DQQ141/PA01/PA01/tools/git_release/release.md

## v1.0.2_release
**Commit:** 04bceb5ce21f668a233e332e9795bd27d4be1026  
**Tagger:** wittxie <wittxie@qq.com>  
**Date:** 2024-12-19 16:16:50 +0800  
**Instructions:**  
  - 外部接口测试页面下打开外部RF电源

---

## v1.0.2_b4
**Commit:** ee4cefda445eccbde6d5258459ebe2d6e53804b8  
**Tagger:** wittxie <wittxie@qq.com>  
**Date:** 2024-12-16 14:38:42 +0800  
**Instructions:**  
  - 默认功率从20dBm改为16dBm

---

## v1.0.2_b3
**Commit:** ab9347e065dc001b2841cdf46fb90238714880c8  
**Tagger:** wittxie <wittxie@qq.com>  
**Date:** 2024-12-16 12:48:05 +0800  
**Instructions:**  
  - 1. 修复protocol丢帧的BUG
  - 2. ring增加传参0判断
  - 3. print_hex8单空格间距

---

## v1.0.2_b2
**Commit:** d0d055a839de3cfe7aa338e8ff0e1452057d1e54  
**Tagger:** wittxie <wittxie@qq.com>  
**Date:** 2024-12-13 13:18:13 +0800  
**Instructions:**  
  - 1. 完成正常模式下的功率设置
  - 2. 串口初始化前先等待RF模块发生的异常波形过去后再初始化

---

## v1.0.2_b1
**Commit:** 098d7aa7b52782c238bbde7deaab07fcfc0df1e0  
**Tagger:** wittxie <wittxie@qq.com>  
**Date:** 2024-12-12 15:29:28 +0800  
**Instructions:**  
  - 新增续航测试页

---

## v1.0.1_b3
**Commit:** fc07d292a5cbe6a9ef467b65b83d4468ac0f9444  
**Tagger:** wittxie <wittxie@qq.com>  
**Date:** 2024-12-10 14:19:28 +0800  
**Instructions:**  
  - 每次发送数据前清空不用的数据

---

## v1.0.1_release
**Commit:** fc07d292a5cbe6a9ef467b65b83d4468ac0f9444  
**Tagger:** wittxie <wittxie@qq.com>  
**Date:** 2024-12-10 14:19:28 +0800  
**Instructions:**  
  - 每次发送数据前清空不用的数据

---

## v1.0.1_b2
**Commit:** 3b72fed73c4d23d7900a8acbd945a6e80e5c2381  
**Tagger:** wittxie <wittxie@qq.com>  
**Date:** 2024-12-10 12:32:48 +0800  
**Instructions:**  
  - 支持V0和V1接收机切换

---

## v1.0.1_b1
**Commit:** 788acda2a361638792b804124892cb0fa8a881c6  
**Tagger:** wittxie <wittxie@qq.com>  
**Date:** 2024-12-10 12:07:15 +0800  
**Instructions:**  
  - 高频认证模式完成

---

## v1.0.0_b6
**Commit:** 77cc065142b8deddcf247d58df7aa7a4046894f5  
**Tagger:** wittxie <wittxie@qq.com>  
**Date:** 2024-12-09 17:23:05 +0800  
**Instructions:**  
  - 1. 修复TypeC测试死机问题
  - 2. 新增功能：RF未响应数据重发
  - 3. 添加看门狗

---

## v1.0.0_b5
**Commit:** 3fc2670b478b5531a9b182b62b596d631e8f7c38  
**Tagger:** wittxie <wittxie@qq.com>  
**Date:** 2024-12-07 23:40:01 +0800  
**Instructions:**  
  - 修复按键测试退出问题

---

## v1.0.0_b4
**Commit:** 644185dd22e365a05aa147c94f5cad350c7add18  
**Tagger:** wittxie <wittxie@qq.com>  
**Date:** 2024-12-07 23:12:10 +0800  
**Instructions:**  
  - 高频和对码V1接收机完成

---

## v1.0.0_b3
**Commit:** 9eb55bb4695a44aec0bb8dbfb28f3d579363e52e  
**Tagger:** wittxie <wittxie@qq.com>  
**Date:** 2024-12-05 22:20:41 +0800  
**Instructions:**  
  - 修复RF固件烧录BUG

---

## v1.0.0_b2
**Commit:** d2f1b89308b18addcdb1949ca973b33defe94057  
**Tagger:** wittxie <wittxie@qq.com>  
**Date:** 2024-12-05 19:05:11 +0800  
**Instructions:**  
  - 完成RF配对功能

---

## v1.0.0_b1
**Commit:** f53dcdbf9bfdfa1f80bacb7604cda74ef678a0b2  
**Tagger:** wittxie <wittxie@qq.com>  
**Date:** 2024-12-05 15:50:36 +0800  
**Instructions:**  
  - 喇叭使能IO口变更PE4

---

## v0.1.3_release
**Commit:** aa7b25e2473075bff66c4d8f1b2460140ef6d70b  
**Tagger:** wittxie <wittxie@qq.com>  
**Date:** 2024-12-03 22:29:36 +0800  
**Instructions:**  
  - 修复BUG:摇杆概率位置显示在左上角
  - 修改FS_PROTOCOL_INRM303一些宏定义

---

## v0.1.3_b12
**Commit:** 76fbbc01c9f5d539a68e3269c339a0af2bb53e45  
**Tagger:** wittxie <wittxie@qq.com>  
**Date:** 2024-12-03 22:11:37 +0800  
**Instructions:**  
  - 修复BUG: 串口测试sport口测试失败

---

## v0.1.3_b11
**Commit:** 076f6f44207169b7c5fce6a1fd8f72ffb8075917  
**Tagger:** wittxie <wittxie@qq.com>  
**Date:** 2024-11-30 17:08:45 +0800  
**Instructions:**  
  - 完成: RF烧录功能完成
  - 
  - 其他: 修改log开关宏

---

## v0.1.3_b10
**Commit:** e71e97c3d4904d2e208e63744a1c109c7291d933  
**Tagger:** wittxie <wittxie@qq.com>  
**Date:** 2024-11-29 20:05:08 +0800  
**Instructions:**  
  - 修复sport通信问题

---

## v0.1.3_b9
**Commit:** 3da8f8a98664e5843cbe4c928462b59ffc0ebcc0  
**Tagger:** wittxie <wittxie@qq.com>  
**Date:** 2024-11-28 22:54:37 +0800  
**Instructions:**  
  - 测试板联调完成

---

## switch_lib_v1.0.1
**Commit:** 6b045651e23eb886eb2212f4c999220ce58efb17  
**Tagger:** wittxie <wittxie@qq.com>  
**Date:** 2024-11-28 16:37:36 +0800  
**Instructions:**  
  - 独立lib

---

## v0.1.3_b8
**Commit:** e4774dde0d212d7c69d922db7c4798f6c709d17b  
**Tagger:** wittxie <wittxie@qq.com>  
**Date:** 2024-11-28 11:56:22 +0800  
**Instructions:**  
  - 拓展IO输出模式默认为推挽

---

## v0.1.3_b7
**Commit:** c5c5642318281350723eaa3e78583f9bd92a3801  
**Tagger:** wittxie <wittxie@qq.com>  
**Date:** 2024-11-27 19:18:02 +0800  
**Instructions:**  
  - 屏幕无残影

---

## v0.1.3_b6
**Commit:** 73004644104cb0097333e159d59023580881802e  
**Tagger:** wittxie <wittxie@qq.com>  
**Date:** 2024-11-25 12:32:03 +0800  
**Instructions:**  
  - 更换FLASH芯片为: MX25L25645G内存芯片

---

## v0.1.3_b5
**Commit:** 3d89d350d95c874a6f5c475836dc4f9e2debd06a  
**Tagger:** wittxie <wittxie@qq.com>  
**Date:** 2024-11-22 22:02:30 +0800  
**Instructions:**  
  - 完成充电检测：USB，底座

---

## v0.1.3_b4
**Commit:** 8ff39e654846d433be48015c45a966b6c40d5734  
**Tagger:** wittxie <wittxie@qq.com>  
**Date:** 2024-11-22 20:13:25 +0800  
**Instructions:**  
  - 优化播放逻辑

---

## v0.1.3_b3
**Commit:** f22743bf04908b84b08a5384ffd739688432eef8  
**Tagger:** wittxie <wittxie@qq.com>  
**Date:** 2024-11-22 18:21:30 +0800  
**Instructions:**  
  - 优化警告等细节

---

## v0.1.3_b2
**Commit:** 2c469fa6db0fae60f30ec917674fa6badc93d531  
**Tagger:** wittxie <wittxie@qq.com>  
**Date:** 2024-11-22 13:09:03 +0800  
**Instructions:**  
  - 1. heap4改为heap5，加大OS内存
  - 2. 关机前先让屏幕进入睡眠模式

---

## v0.1.3_b1
**Commit:** 932497447639998d7fc42c032581a5f15675df51  
**Tagger:** wittxie <wittxie@qq.com>  
**Date:** 2024-11-21 23:09:22 +0800  
**Instructions:**  
  - 1.定时刷新屏幕寄存器
  - 2.重写player，改为声音专用播放器

---

## v0.1.2
**Commit:** 8230a77e9f39f45e246ddd8b9e747bbc89dcf313  
**Tagger:** wittxie <wittxie@qq.com>  
**Date:** 2024-11-20 23:07:33 +0800  
**Instructions:**  
  - 声音完成

---
