DQQ141/PA01/PA01/tools/replace/搜索技巧.md

所有括号内的内容：`\((.*?)\)`

所有括号外部的内容：`^[^(]+|[^)]+$`
