DQQ141/PA01/PA01/doc/原理图/主板原理图 v0.0.2.pdf

BAT Voltage Detection | DC BUCK +3V3

3A

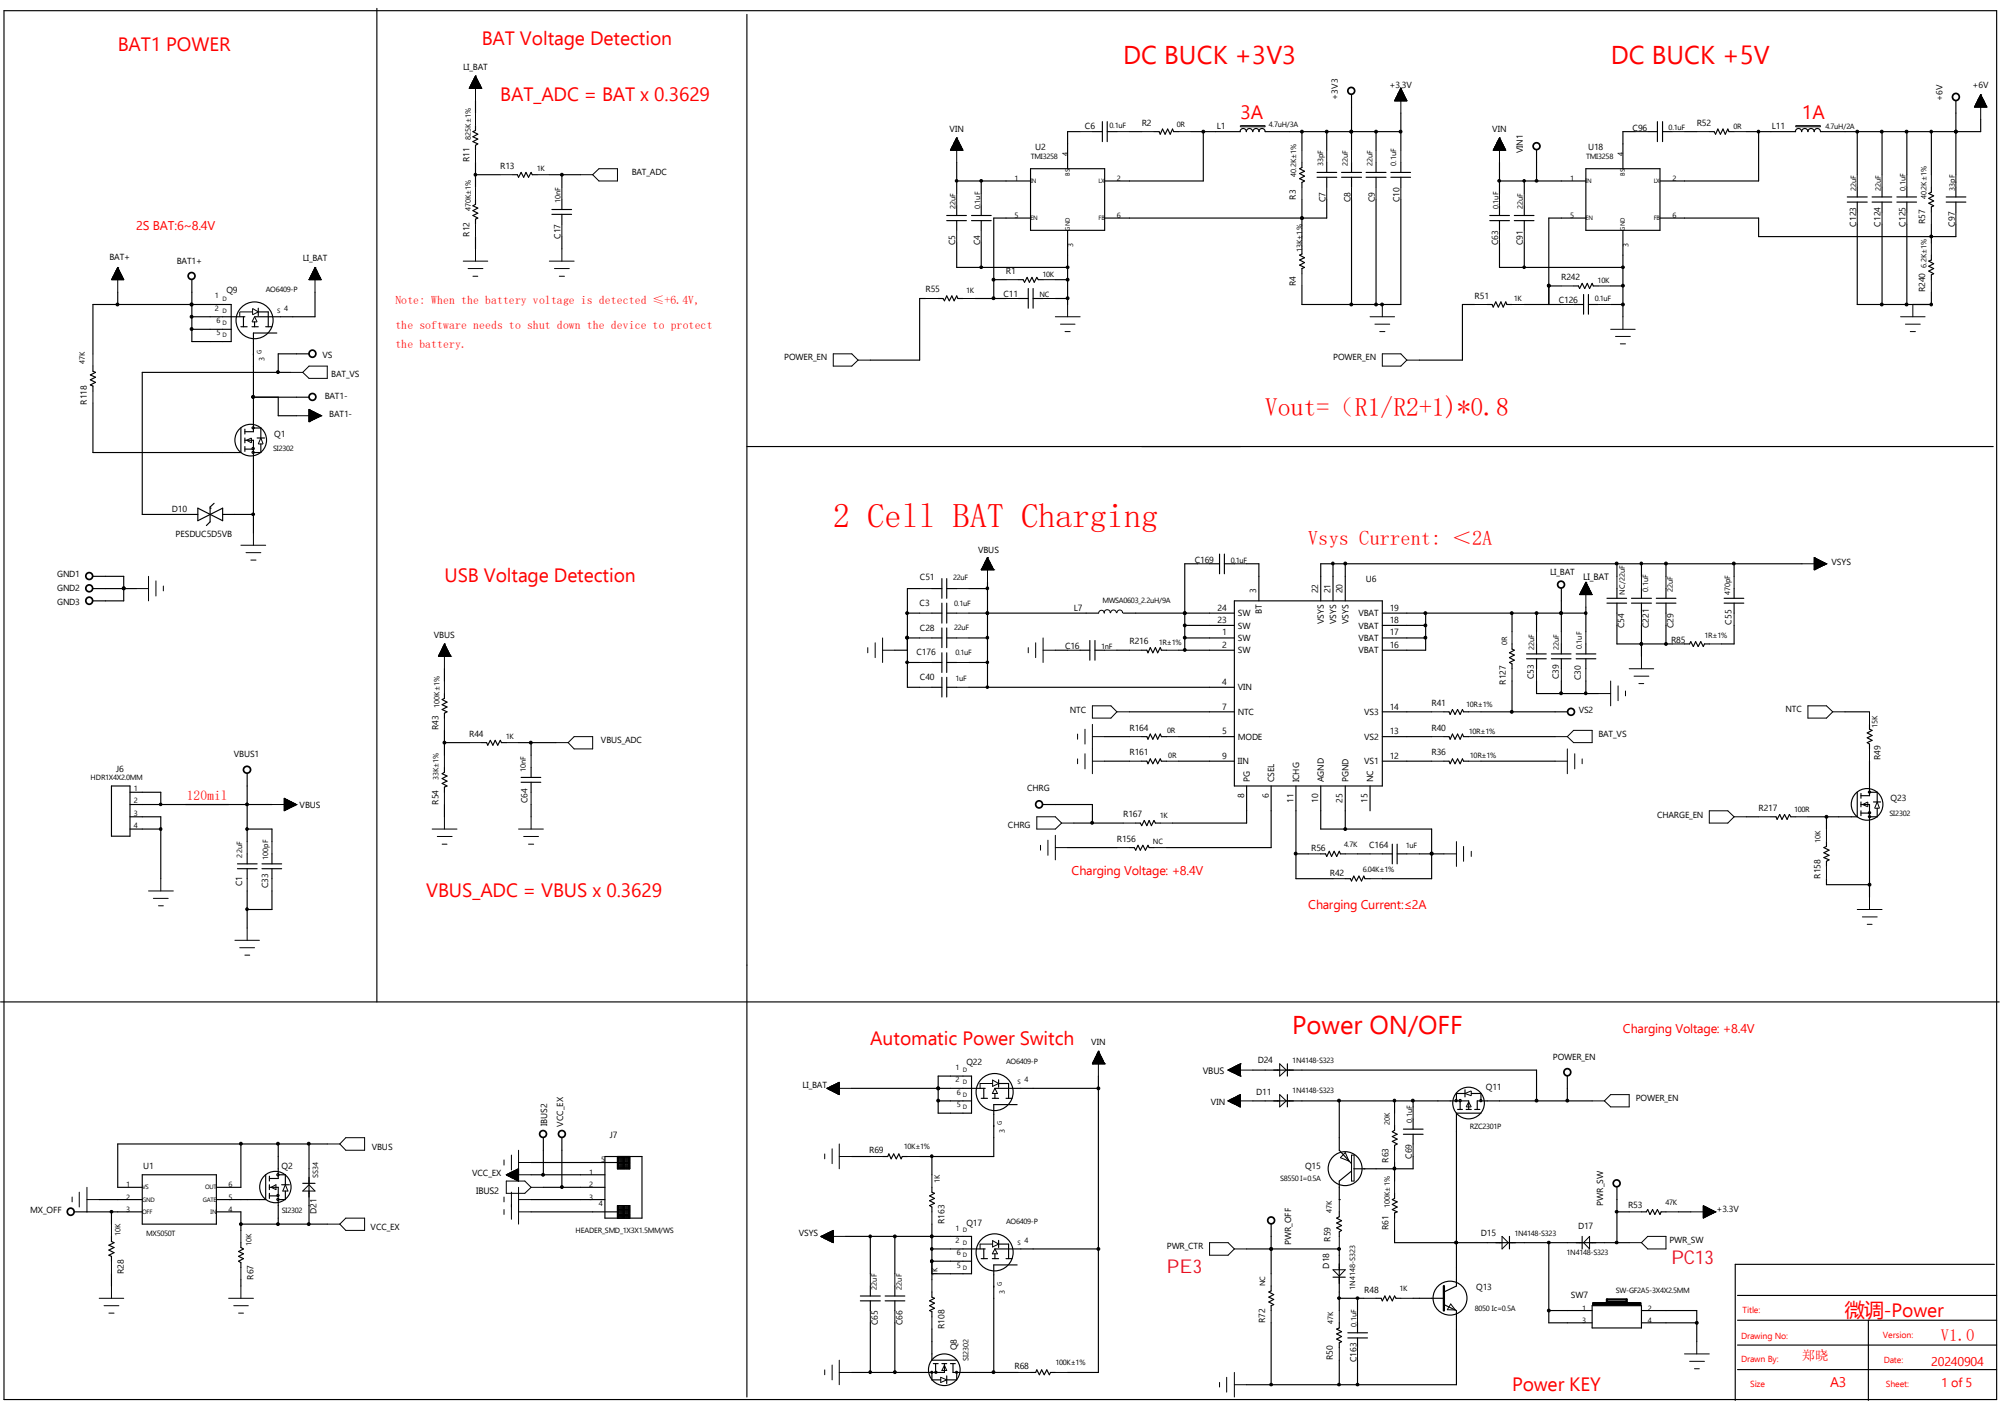
[picture p9: page 1]

Note: When the battery voltage is detected ≤+6.4V,

the software needs to shut down the device to protect
the battery.

Drawing No: | V1.0 Version:
郑晓 Drawn By: | Date:

A3 Size | Sheet:

TR3- | TR3+ | TR4+ | TR4-
| | TR2- | TR2+

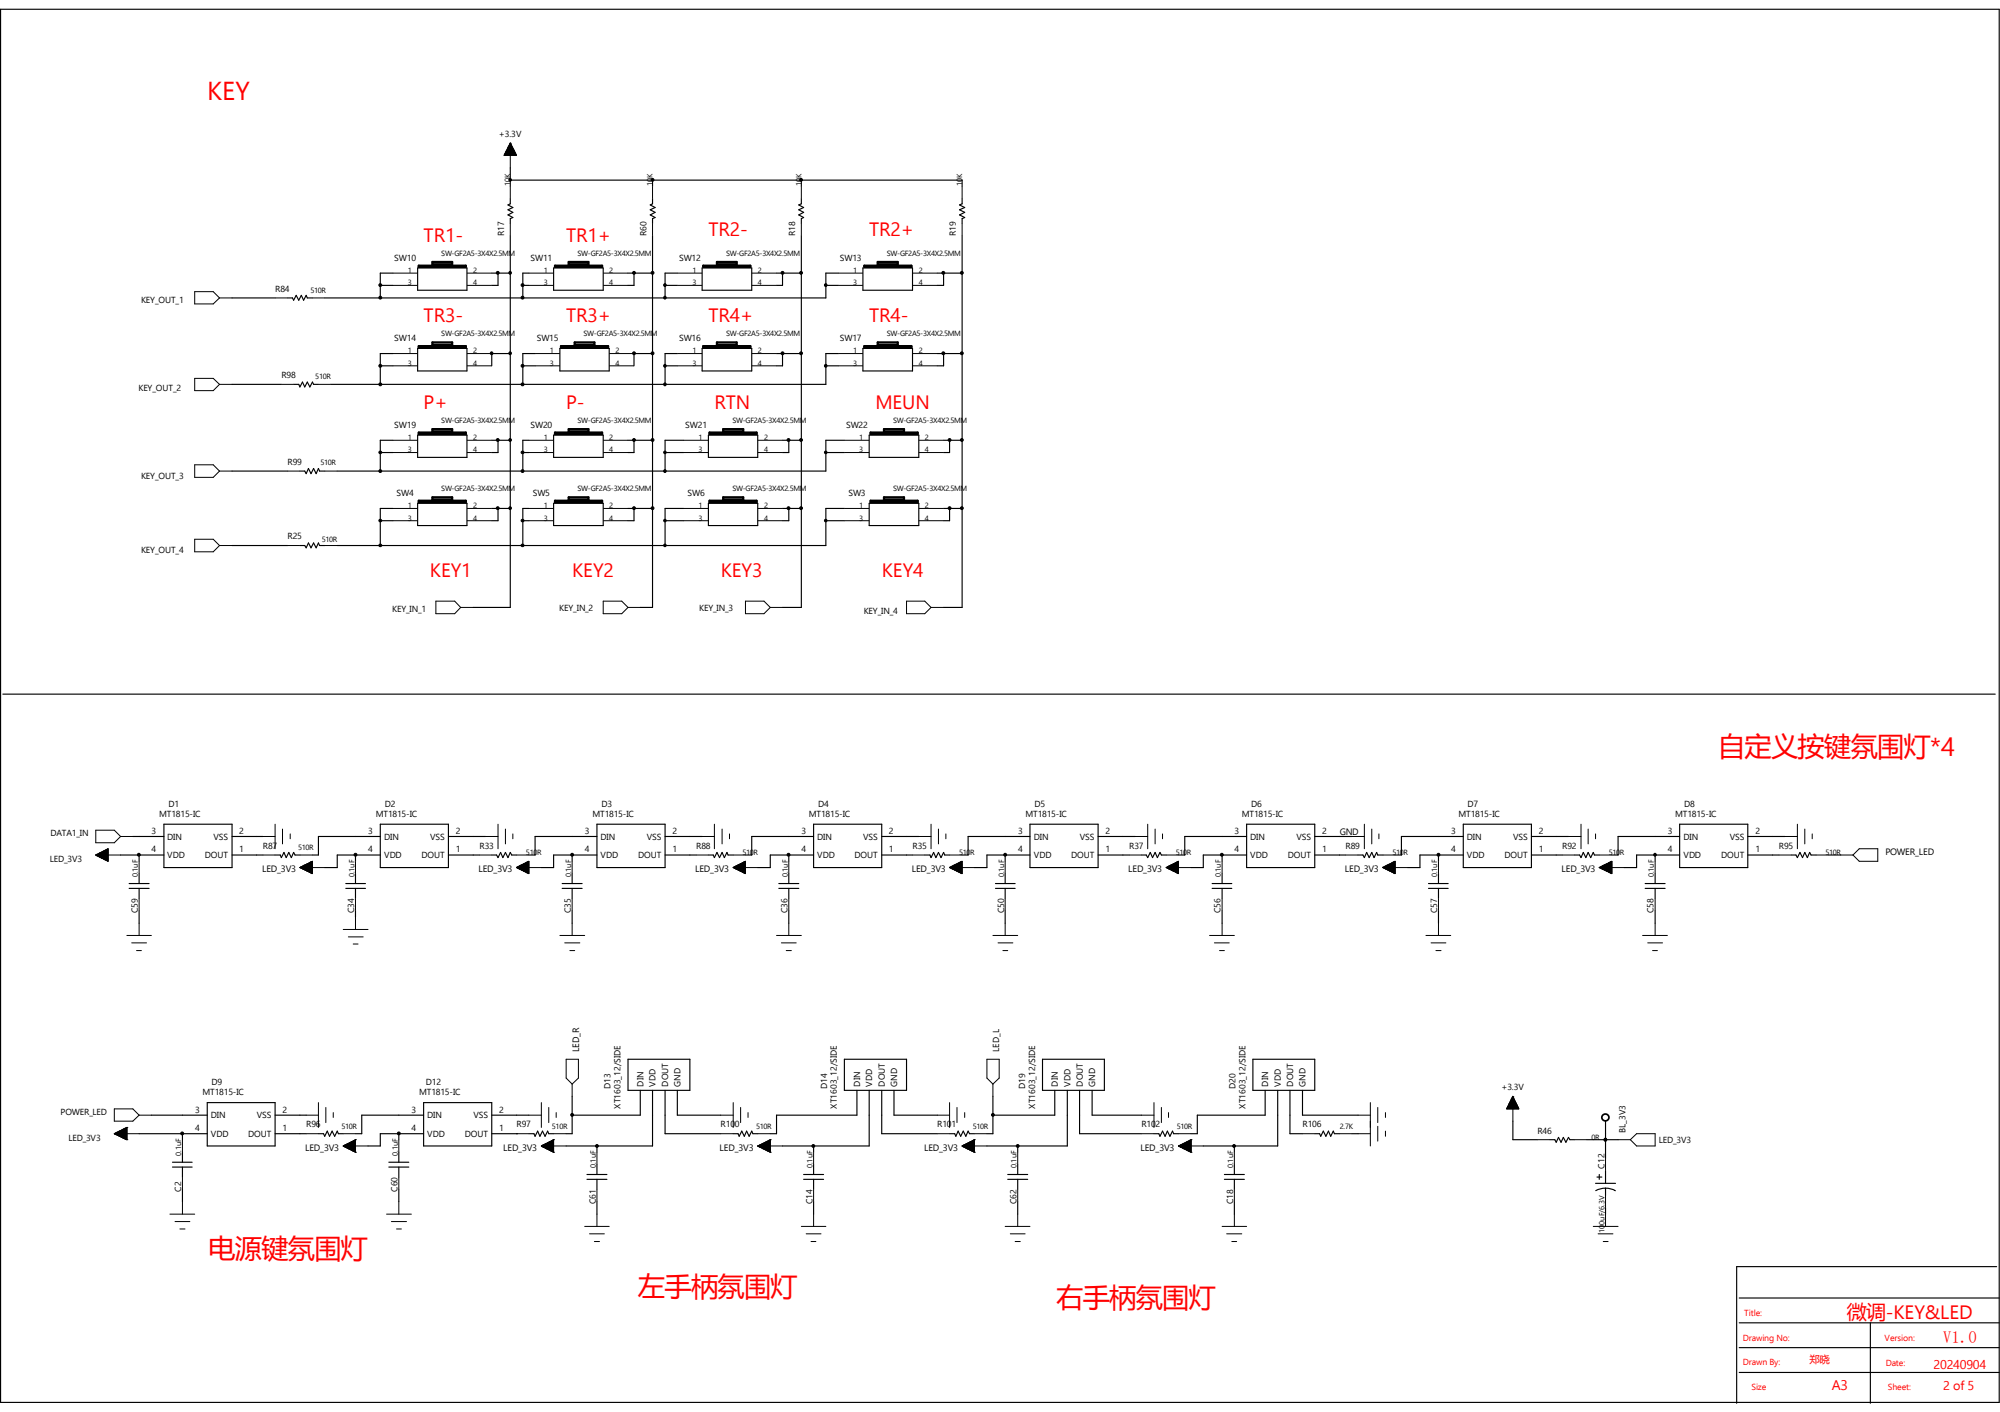
[picture p10: page 2]

# VR2 VR1

# Potentiometer Knob

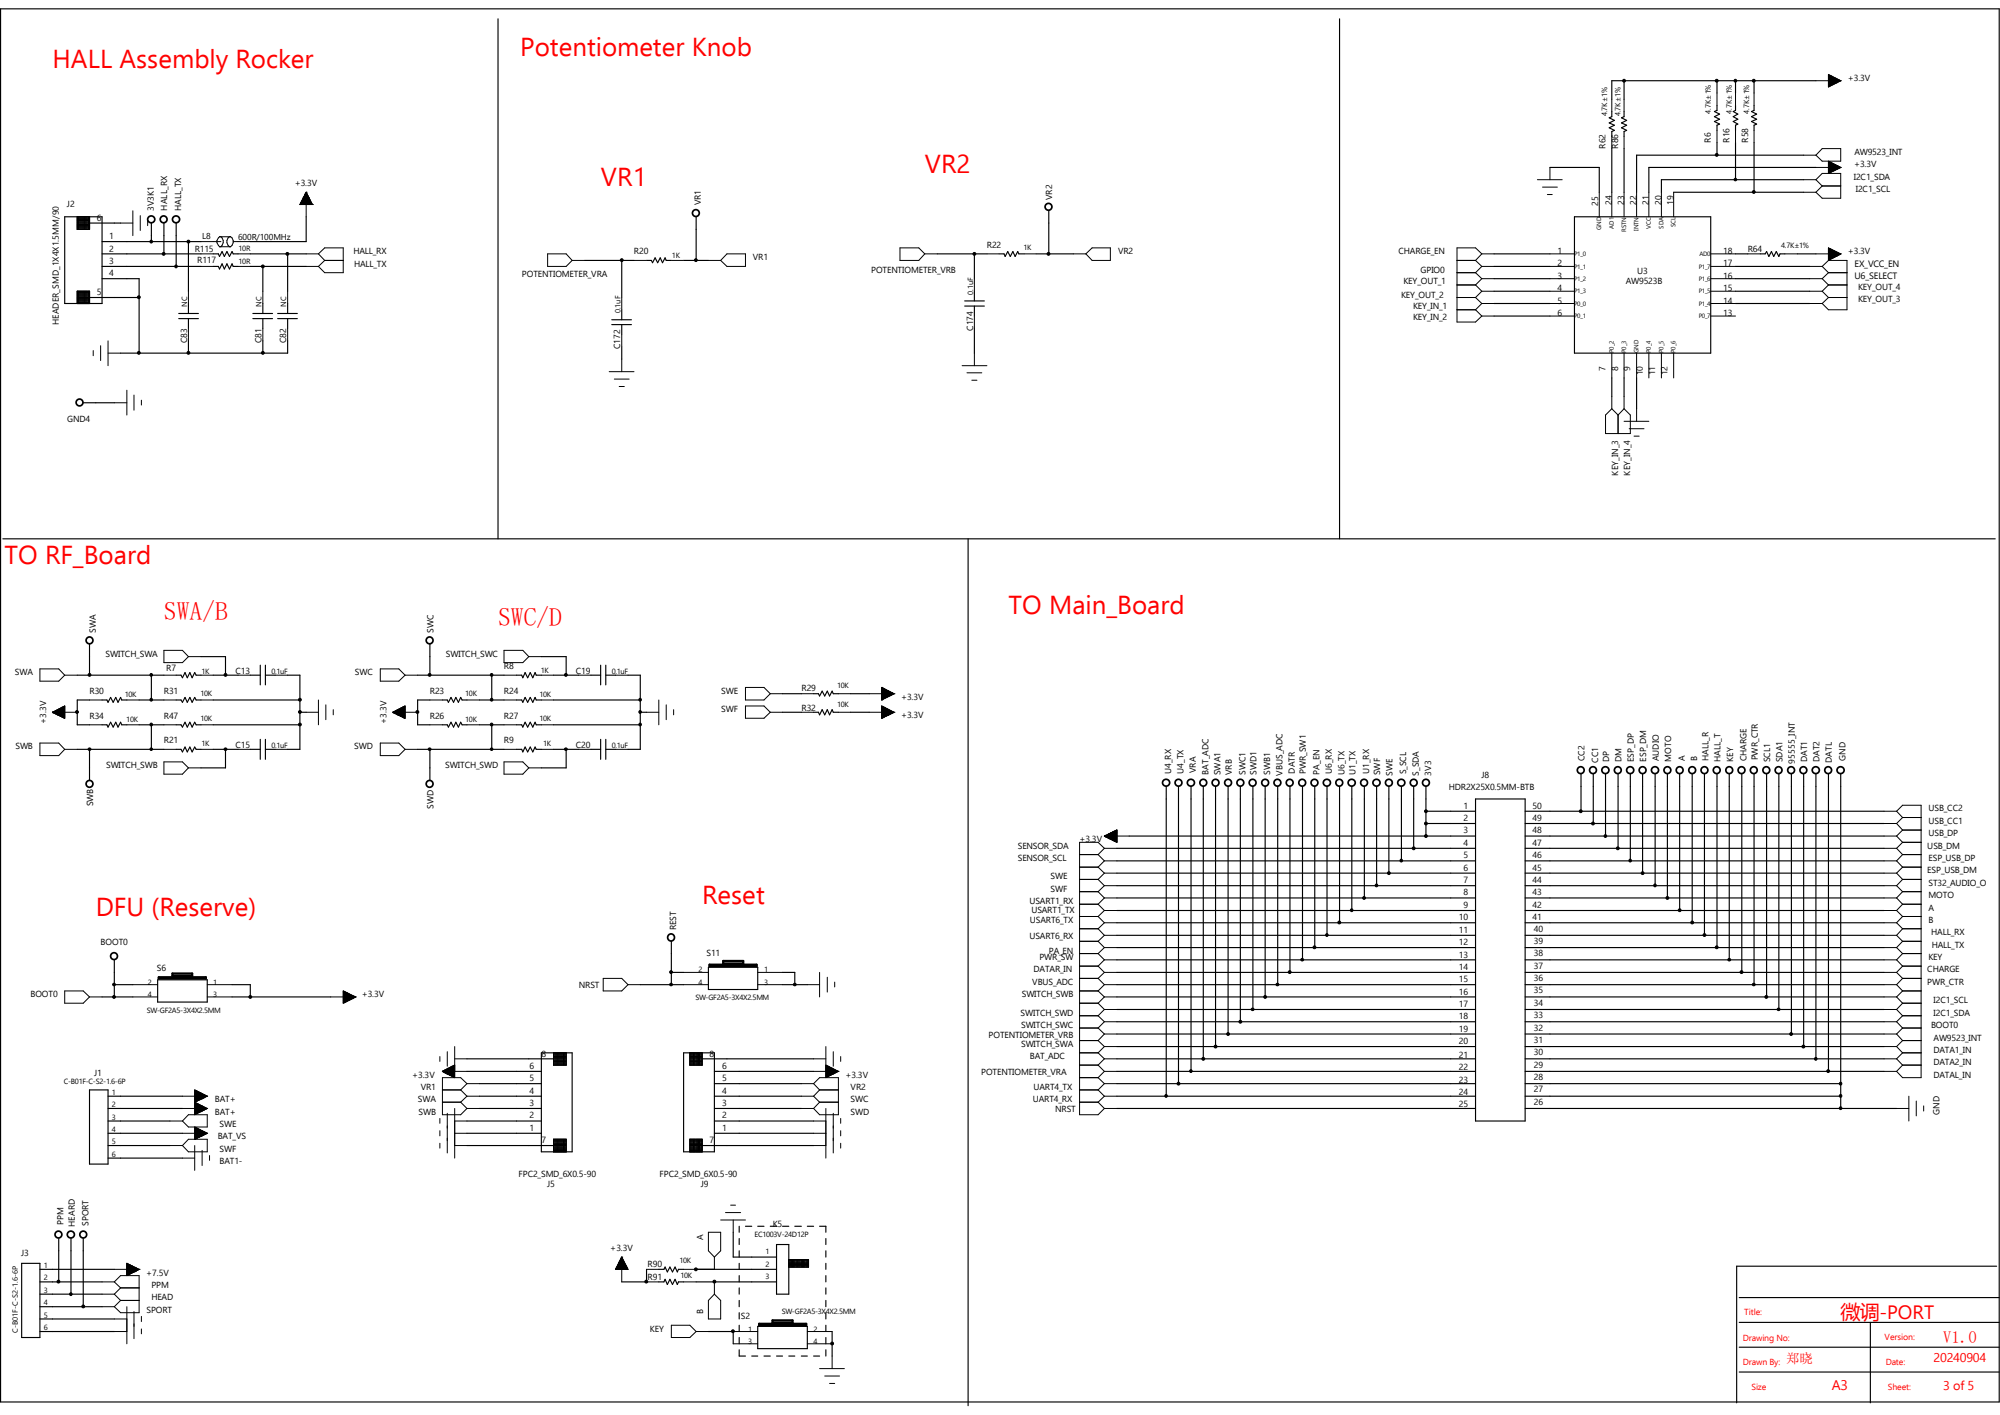
[picture p11: page 3]

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
# Audio Outputs

# Gyroscope

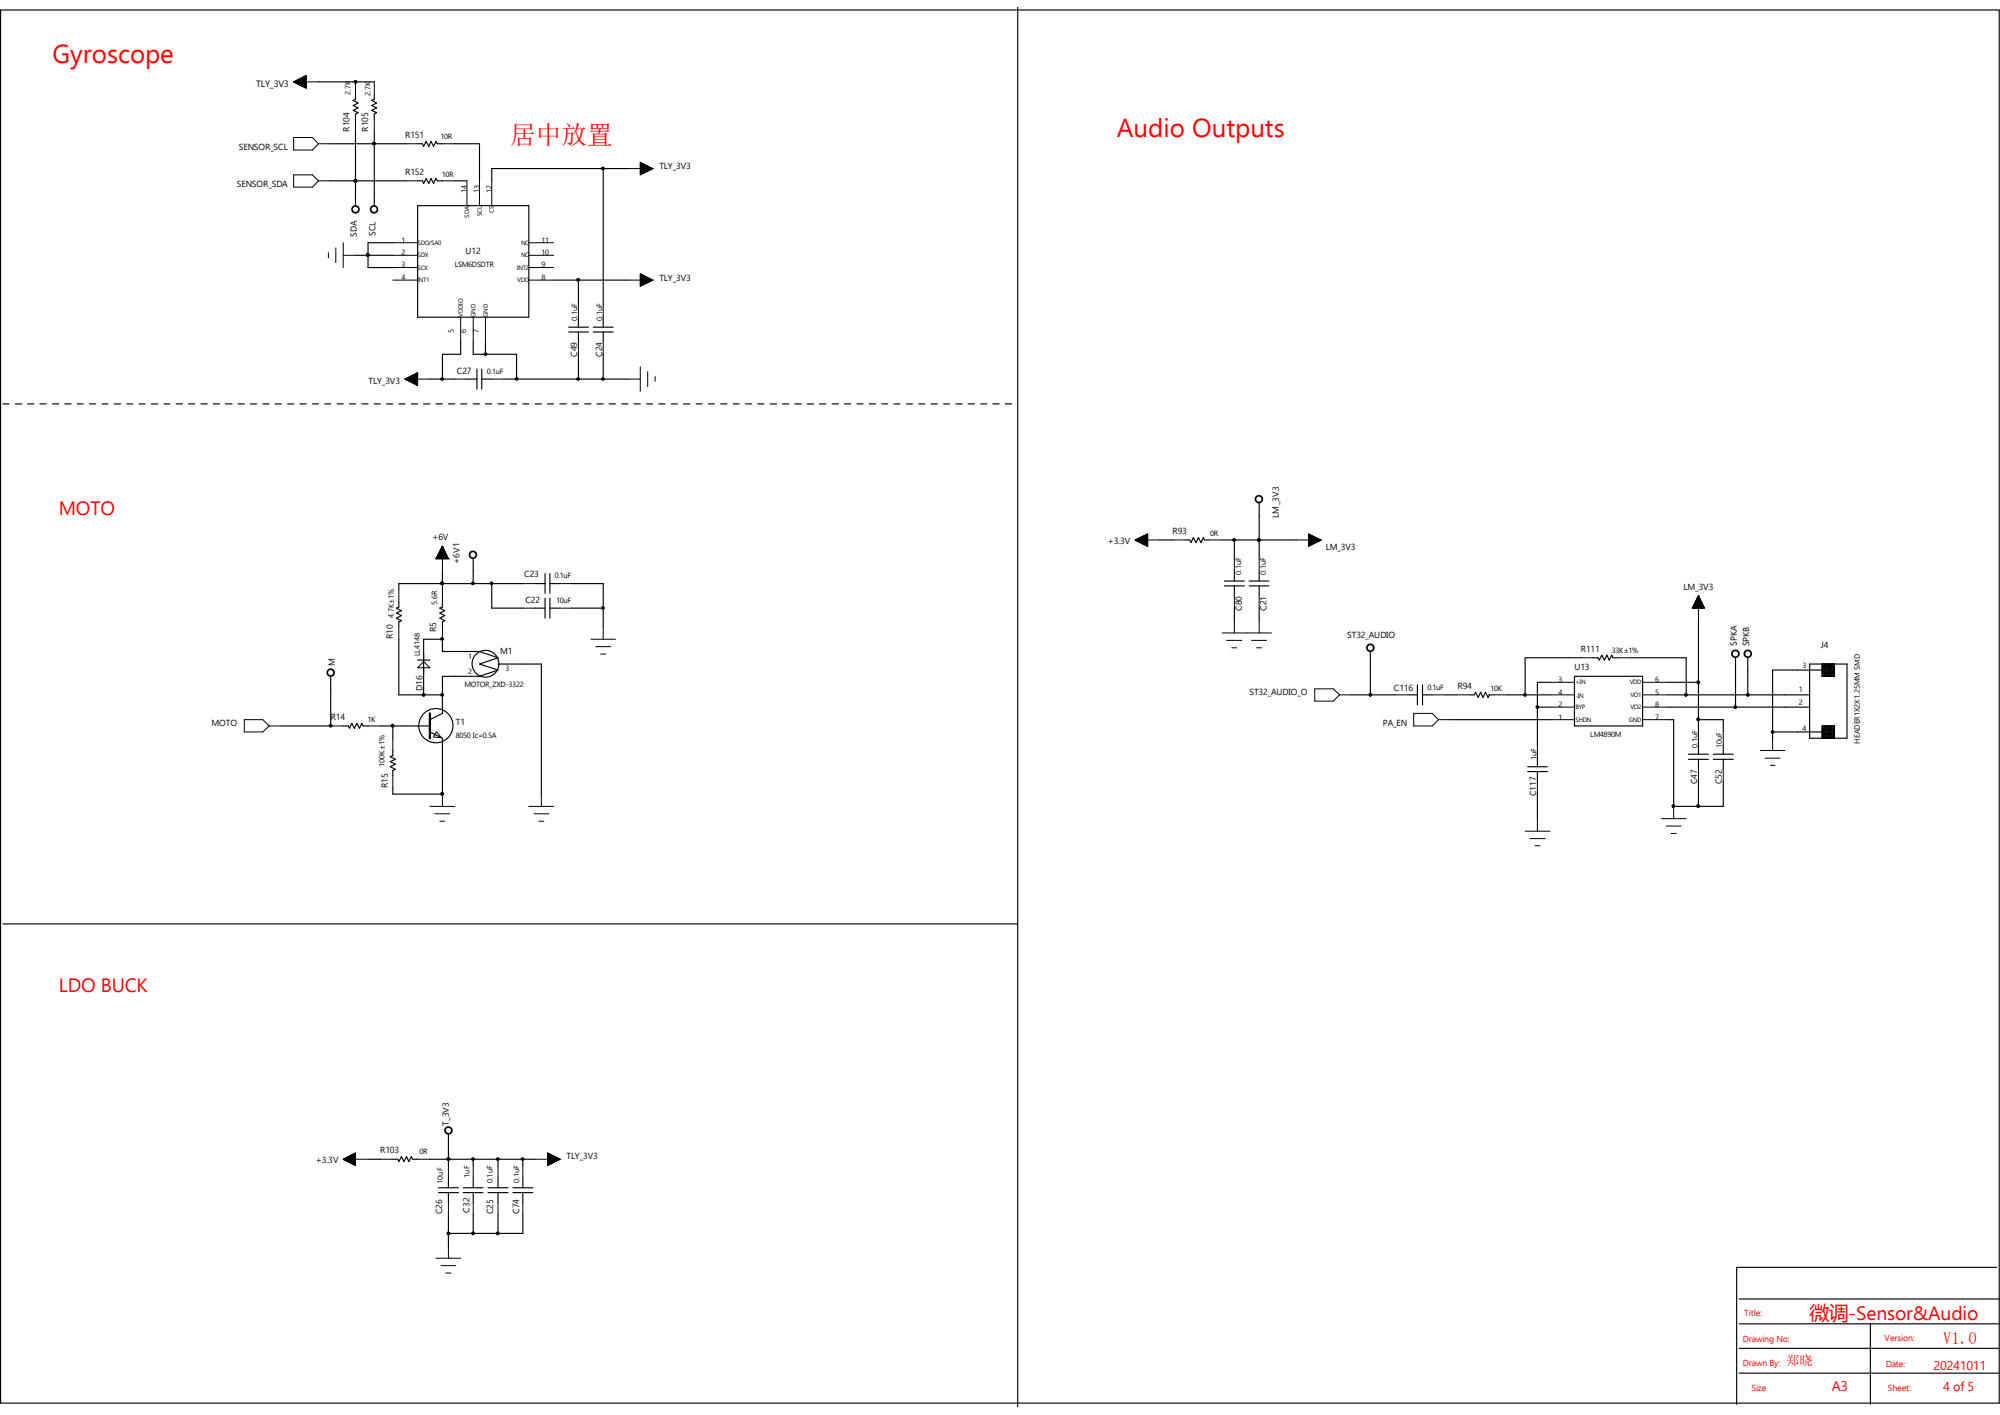
[picture p12: page 4]

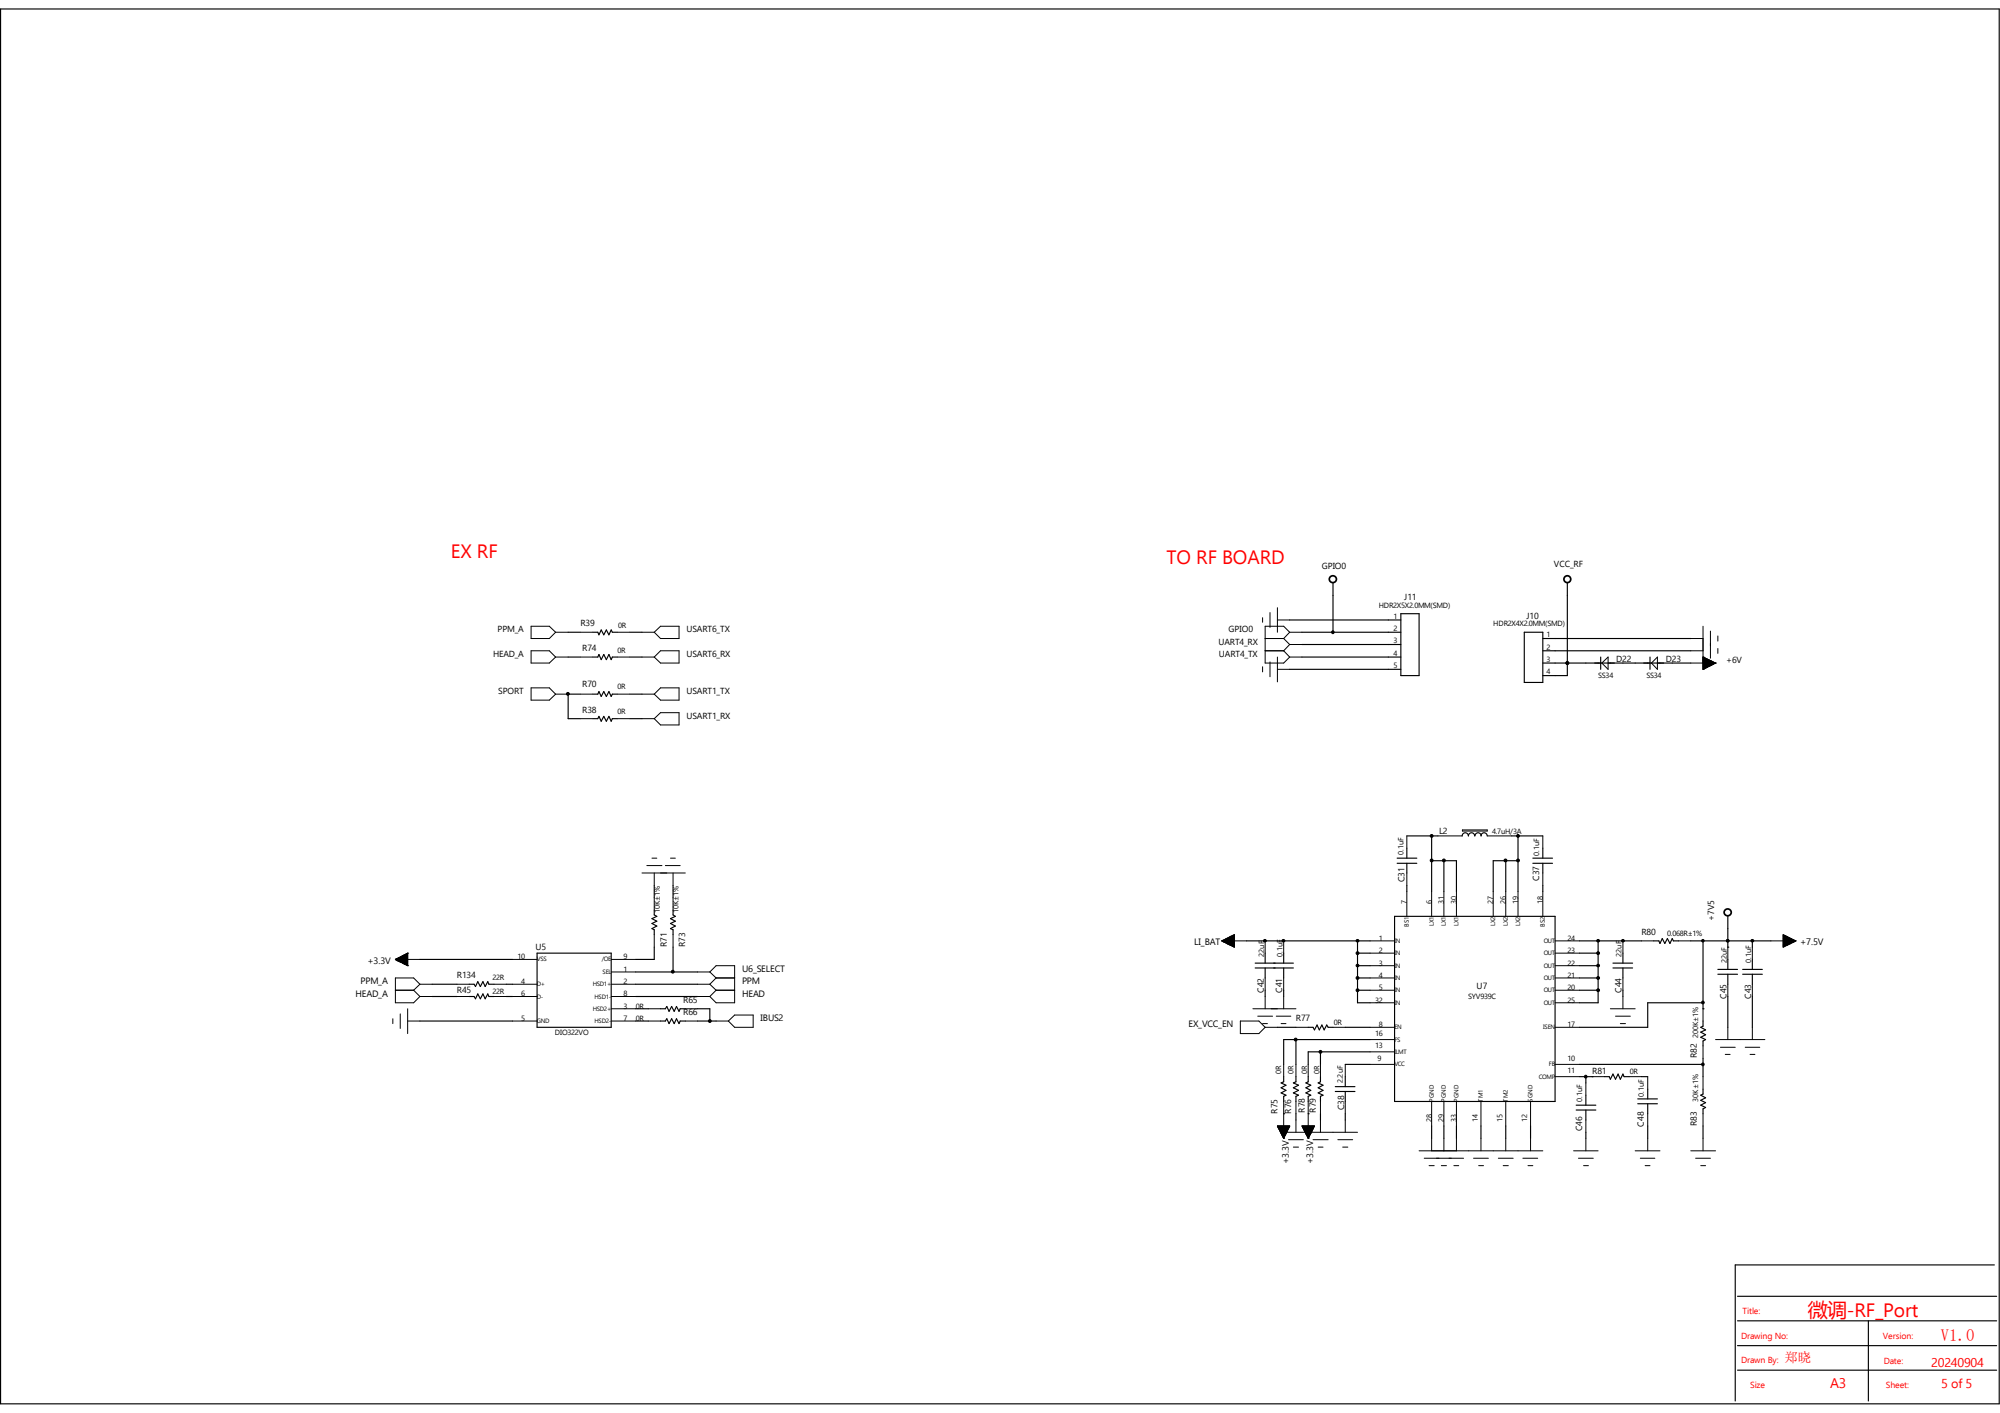
[picture p13: page 5]
