DQQ141/PA01/PA01/doc/原理图/核心板原理图 v0.0.2.pdf

## 120mil

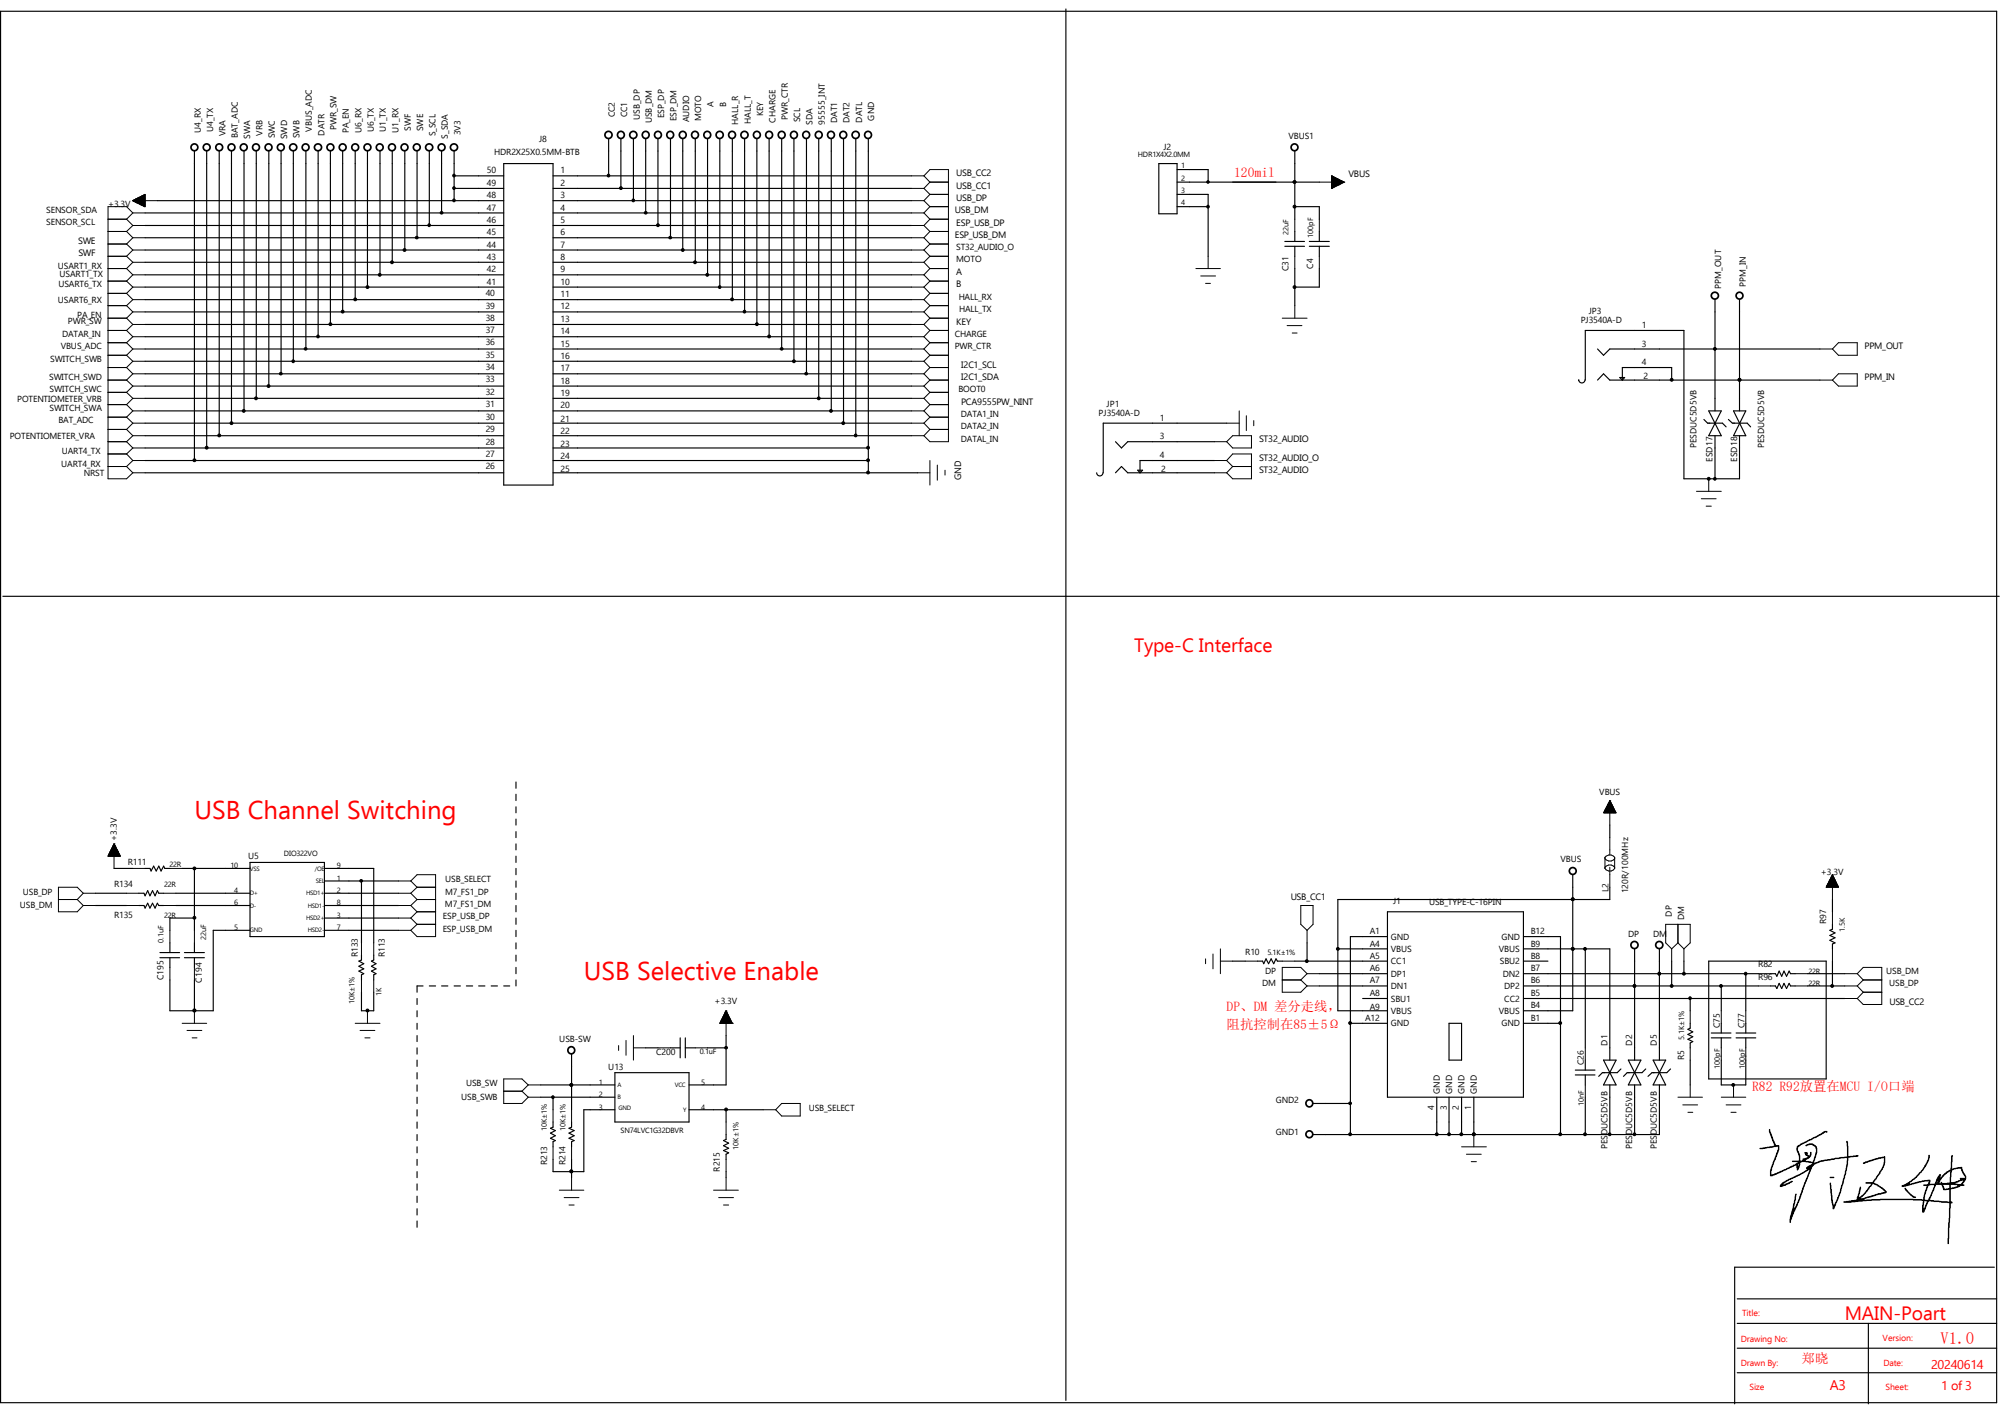
[picture p14: page 1]

VBUS1

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
Drawing No: | Version: V1.0
郑晓 Drawn By: | Date:

Size A3 | Sheet:

# Reset

# SDRAM 64M 16bit

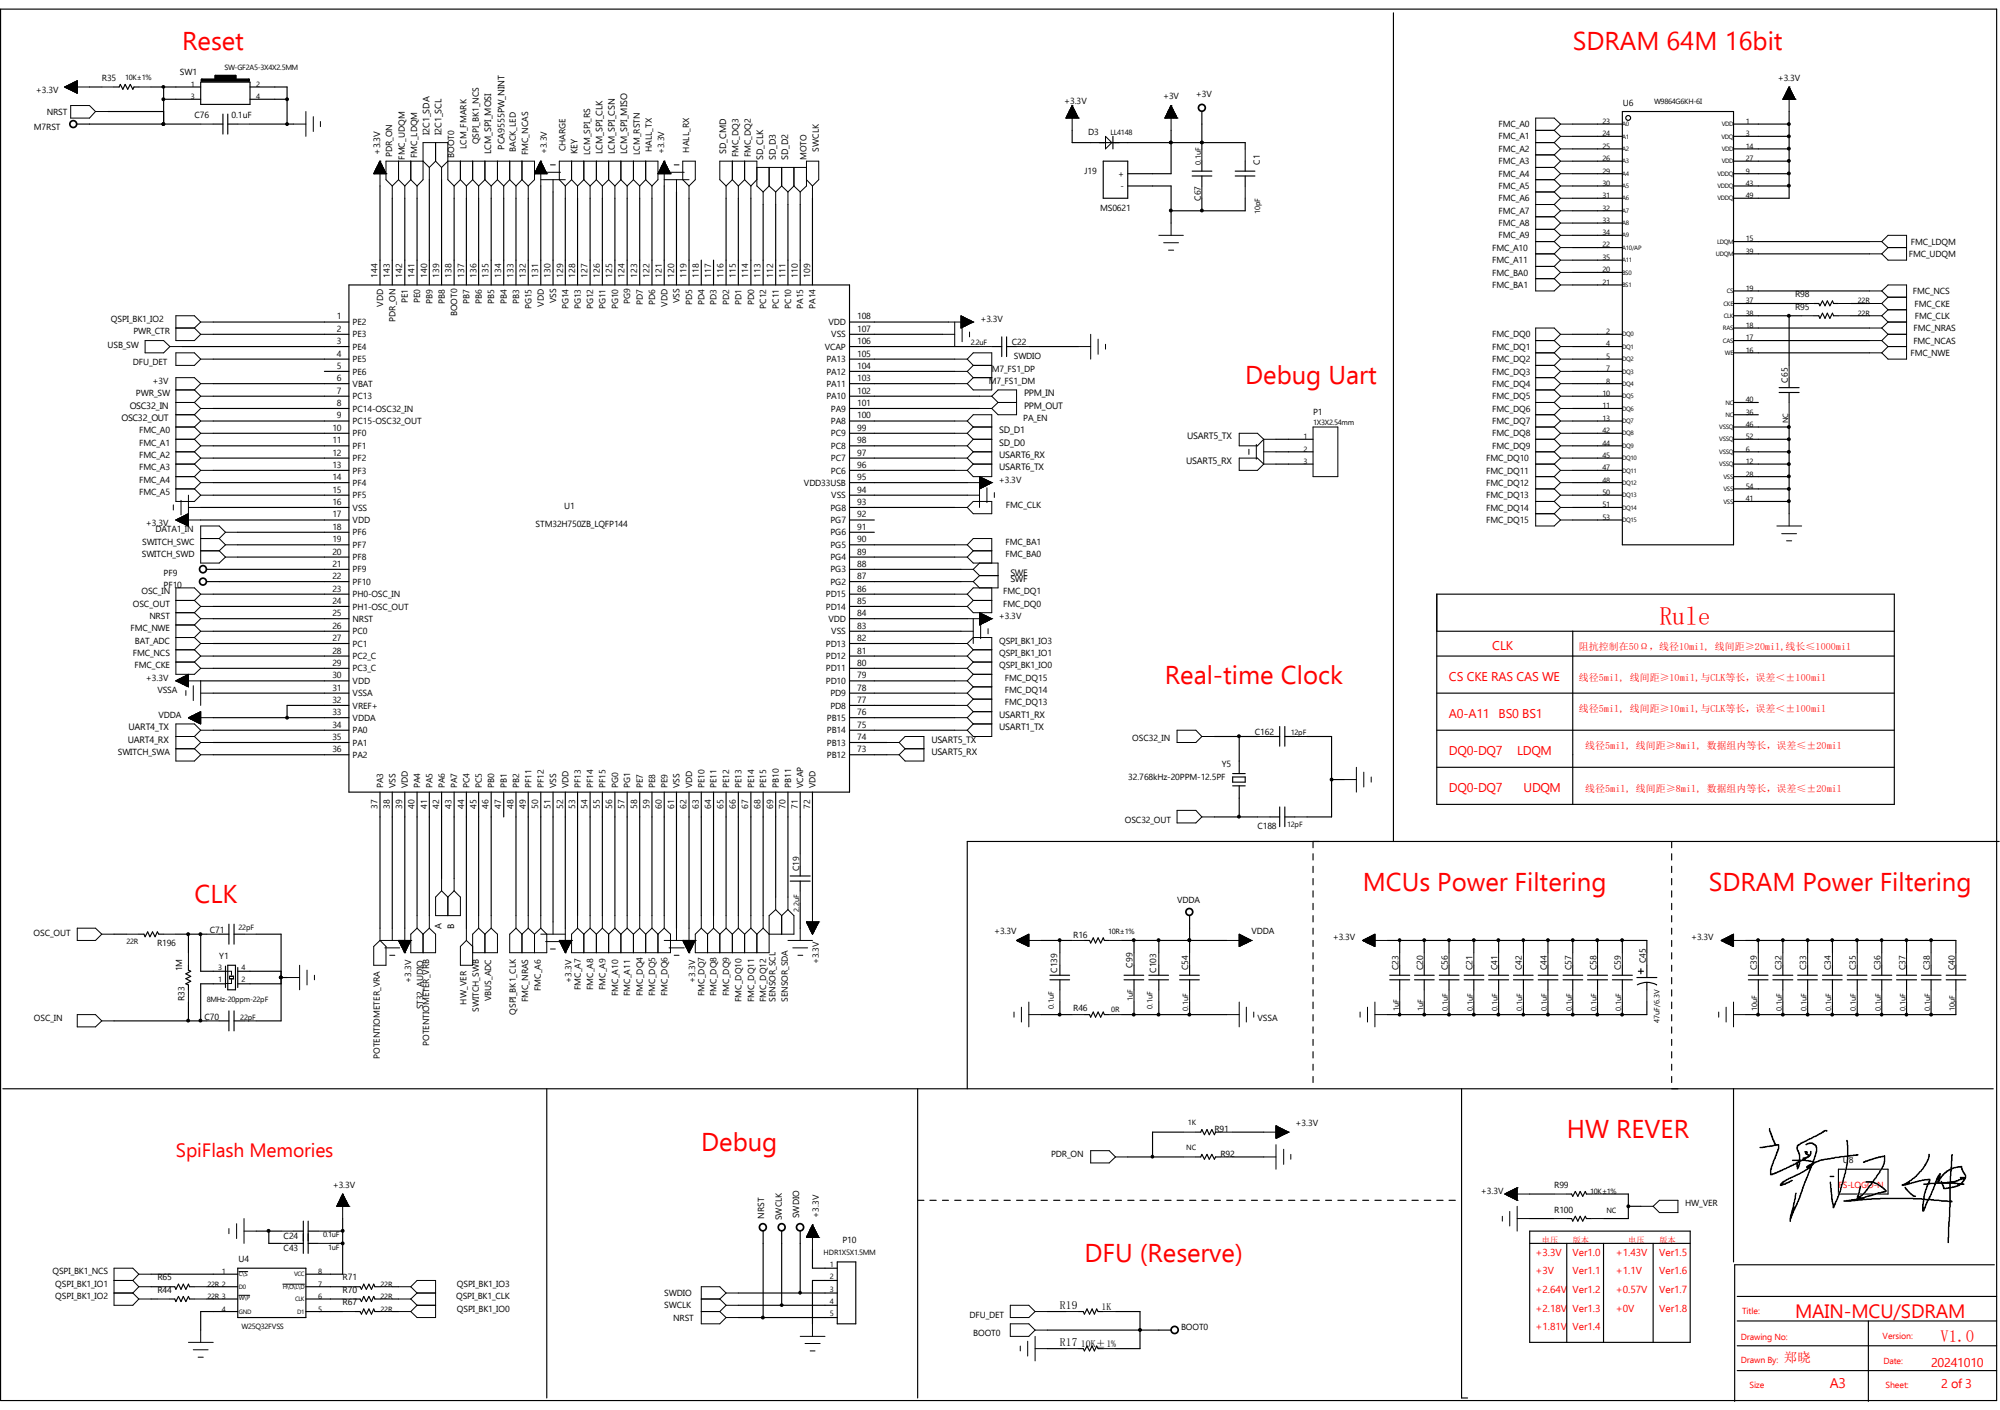
[picture p15: page 2]

CS CKE RAS CAS WE

+3.3V +3V +2.64V +2.18V +1.81V | Ver1.0 Ver1.1 Ver1.2 Ver1.3 Ver1.4 | +1.43V +1.1V +0.57V +0V | Ver1.5 Ver1.6 Ver1.7 Ver1.8

Drawing No: | V1.0 Version:

# TFT-LCD

# Pixel pitch (W XH)：0.153x0.153mm

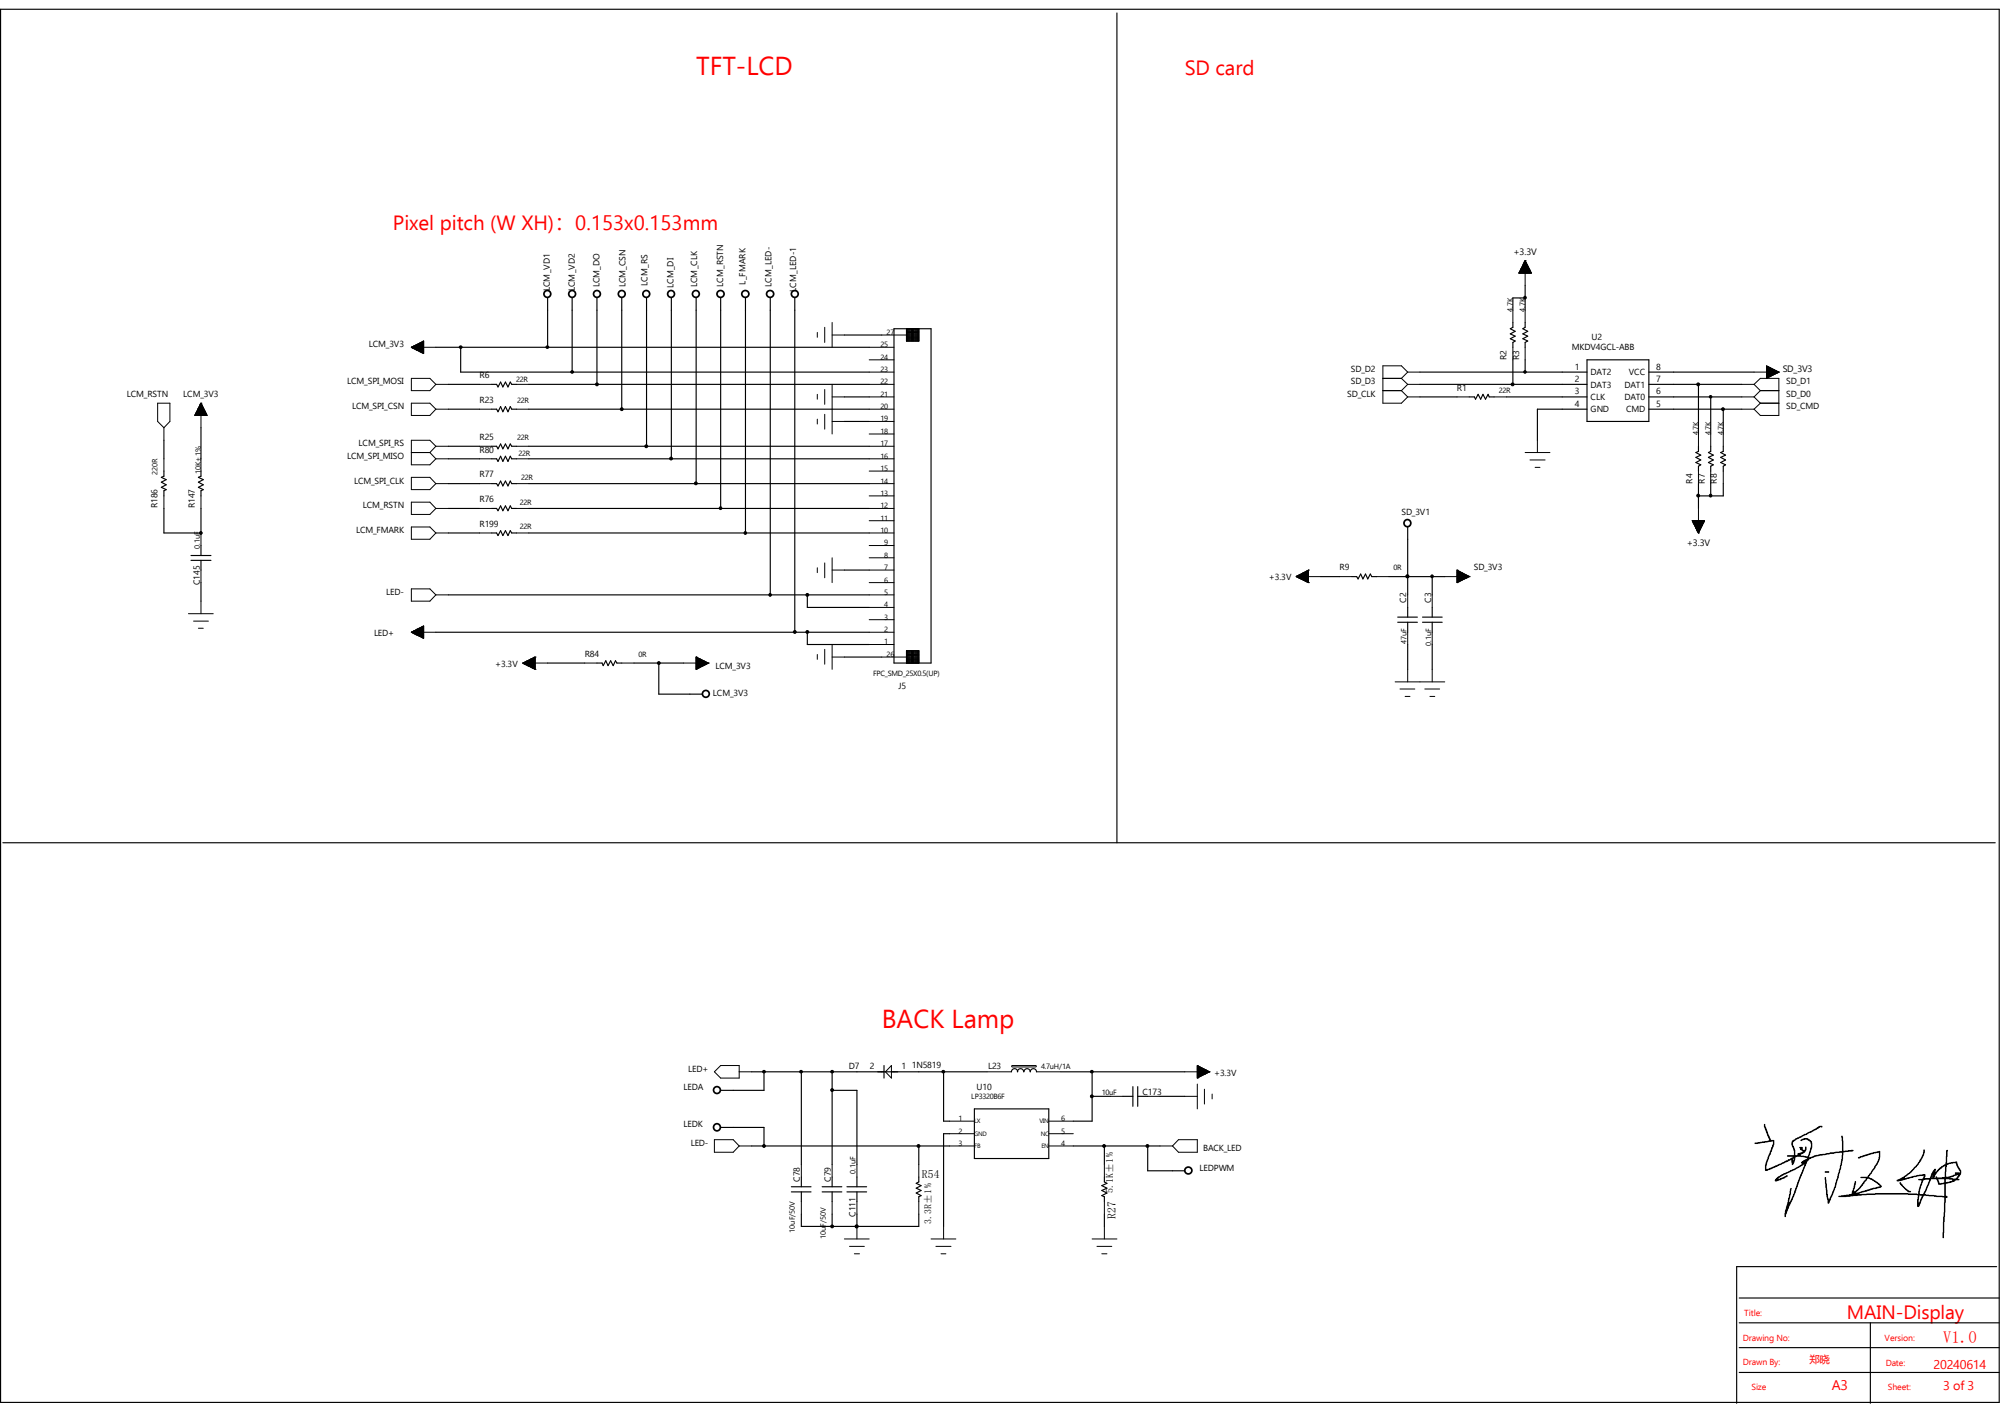
[picture p16: page 3]
