DQQ141/PA01/PA01/doc/原理图/others/PA01-BA-MAIN-V1.0-20240812.pdf

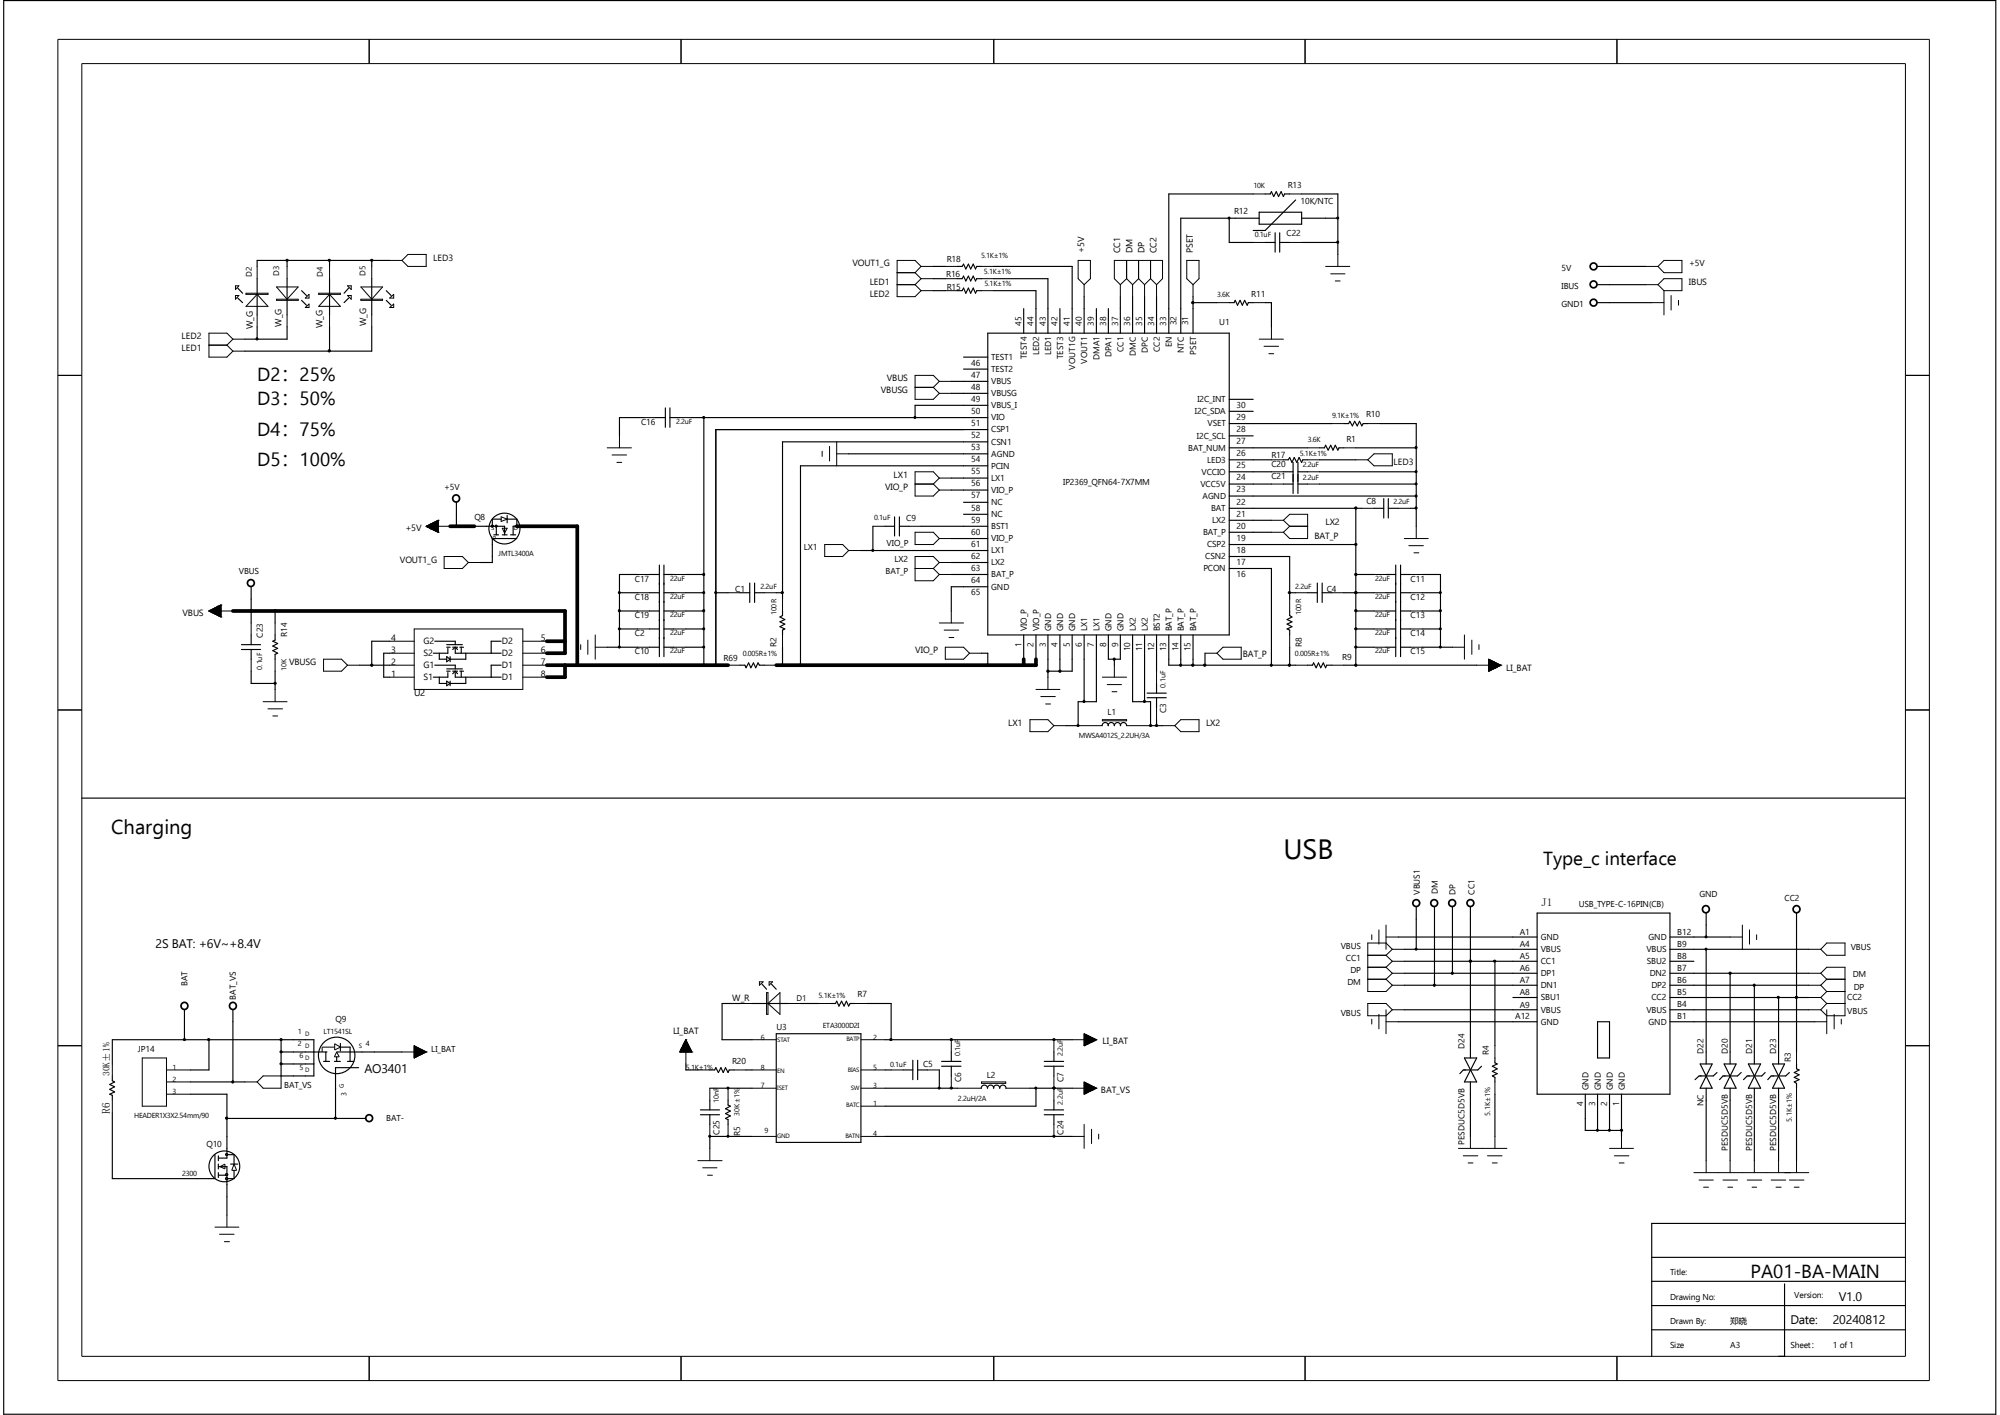
[picture p17: page 1]

LX2 BAT_P

1 VIO_P 2 VIO_P 3 GND 4 GND 5 GND 6 LX1 7 LX1 8 GND 9 GND

B6 DP2
B5 CC2
B4 VBUS

Drawing No: | Version: V1.0

Drawn By: 郑晓 | Date: 20240812

Size A3 | Sheet： 1 of 1
