DQQ141/PA01/PA01/doc/原理图/others/PA01-FPC-SWAB-V1.0-20240620.pdf

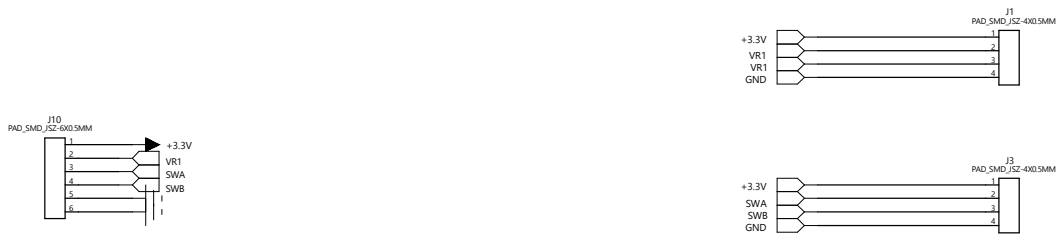
[picture p18: page 1]
Title:; PA01 FPC SWAB; J1 PAD_SMD_JSZ-4X0.5MM; J10 PAD_SMD_JSZ-6X0.5MM; J3 PAD_SMD_JSZ-4X0.5MM; GND; VR1 SWA SWB; SWB; SWA

Drawing No: | V1.0 Version:

郑晓 Drawn By: | 20240620 Date:

Size A3 | Sheet: 1 of 1

# 修改记录：

T0-20220630

# 1、初始版本

T0-20221010

# 1、将接线端子改为FPC座 2、钮子开关和拨轮分开分别使用卧式FPC座
