DQQ141/PA01/PA01/doc/原理图/others/PA01-FPC-VR-V1.0-20240620.pdf

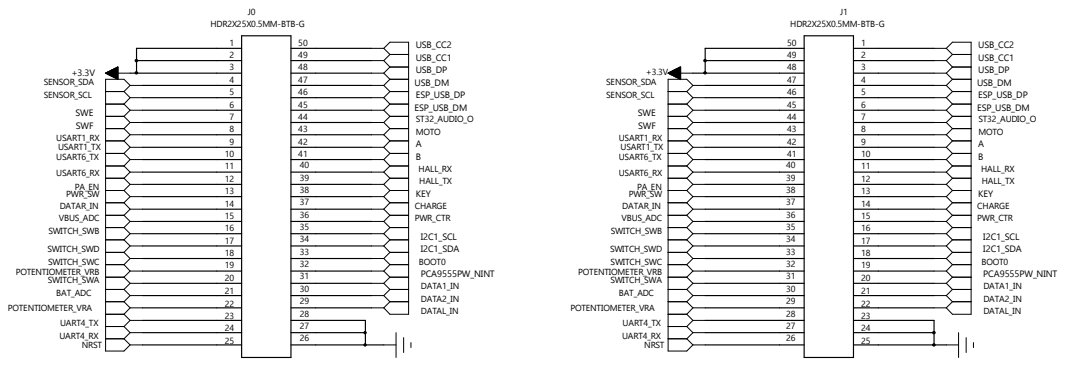
[picture p20: page 1]
Title:; PA01 FPC VR; J0 HDR2X25X0.5MM-BTB-G; J1 HDR2X25X0.5MM-BTB-G; KEY; DATAR_IN; SENSOR_SDA SENSOR_SCL; SWE SWF; USART1_TX; USART1_RX; USART6_TX; USART6_RX; PA_EN PWR_SW; USB_DP; USB_DM; USB_CC1; USB_CC2; ST32_AUDIO_O MOTO A B; ESP_USB_DP; ESP_USB_DM; HALL_RX HALL_TX; CHARGE PWR_CTR; PCA9555PW_NINT; I2C1_SCL I2C1_SDA BOOT0; DATA1_IN DATA2_IN DATAL_IN POTENTIOMETER_VRA; POTENTIOMETER_VRB SWITCH_SWA; SWITCH_SWB; SWITCH_SWC; SWITCH_SWD; NRST; UART4_RX; UART4_TX; VBUS_ADC; BAT_ADC

Drawing No: | V1.0 Version:

郑晓 Drawn By: | 20240620 Date:

Size A3 | Sheet: 1 of 1

# 修改记录：

T0-20220630

# 1、初始版本

T0-20221010

# 1、将接线端子改为FPC座 2、钮子开关和拨轮分开分别使用卧式FPC座
