DQQ141/PA01/PA01/doc/原理图/others/PA01-PORT-T0 20240808.pdf

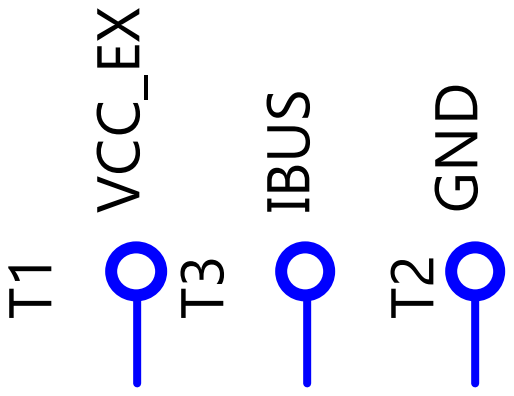
[picture p24: page 1]
Title:; PA01-PORT; VCC_EX; GND; IBUS

Drawing No: | Version: V1.0

Drawn By: 郑晓 | Date: 20240808

Size A3 | Sheet: 1 of 1
