DQQ141/PA01/PA01/doc/原理图/others/PA01-SWCD-T0 20240619.pdf

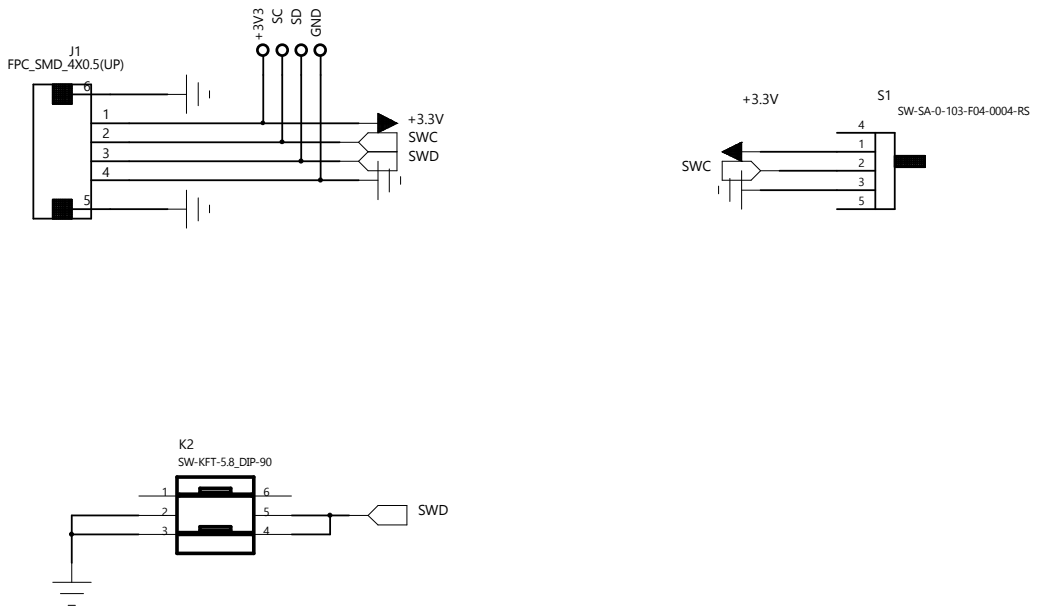
[picture p26: page 1]
Title:; SWCD; GND; J1 FPC_SMD_4X0.5(UP); SW-KFT-5.8_DIP-90; SWC; SWD

Drawing No: | Version: V1.0

Drawn By: 郑晓 | Date: 20240620

Size A3 | Sheet: 1 of 1
