DQQ141/PA01/PA01/doc/原理图/others/PA01-VRL-T0 20240612.pdf

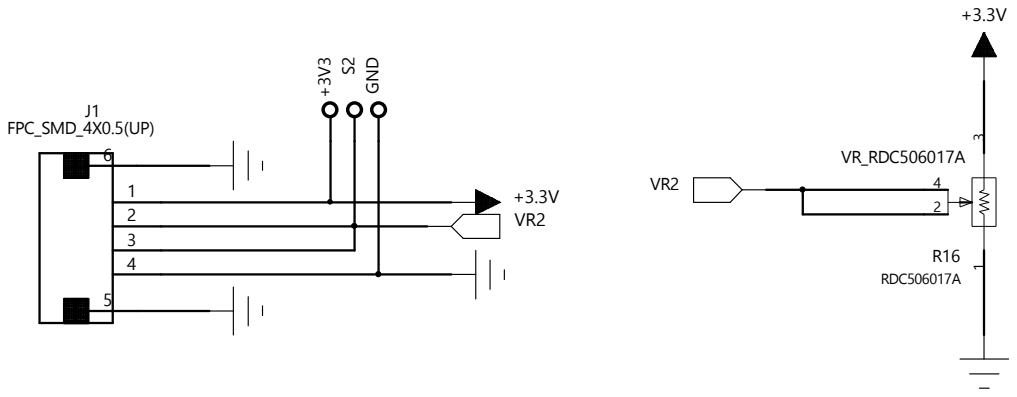
[picture p27: page 1]
Title:; VRL; VR_RDC506017A; RDC506017A; GND; J1 FPC_SMD_4X0.5(UP)

Drawing No: | Version: V1.0

Drawn By: 郑晓 | Date: 20240612

Size A3 | Sheet: 1 of 1
