DQQ141/PA01/PA01/doc/原理图/others/PA01-微调-T0 20240806.pdf

BAT Voltage Detection | DC BUCK +3V3

3A

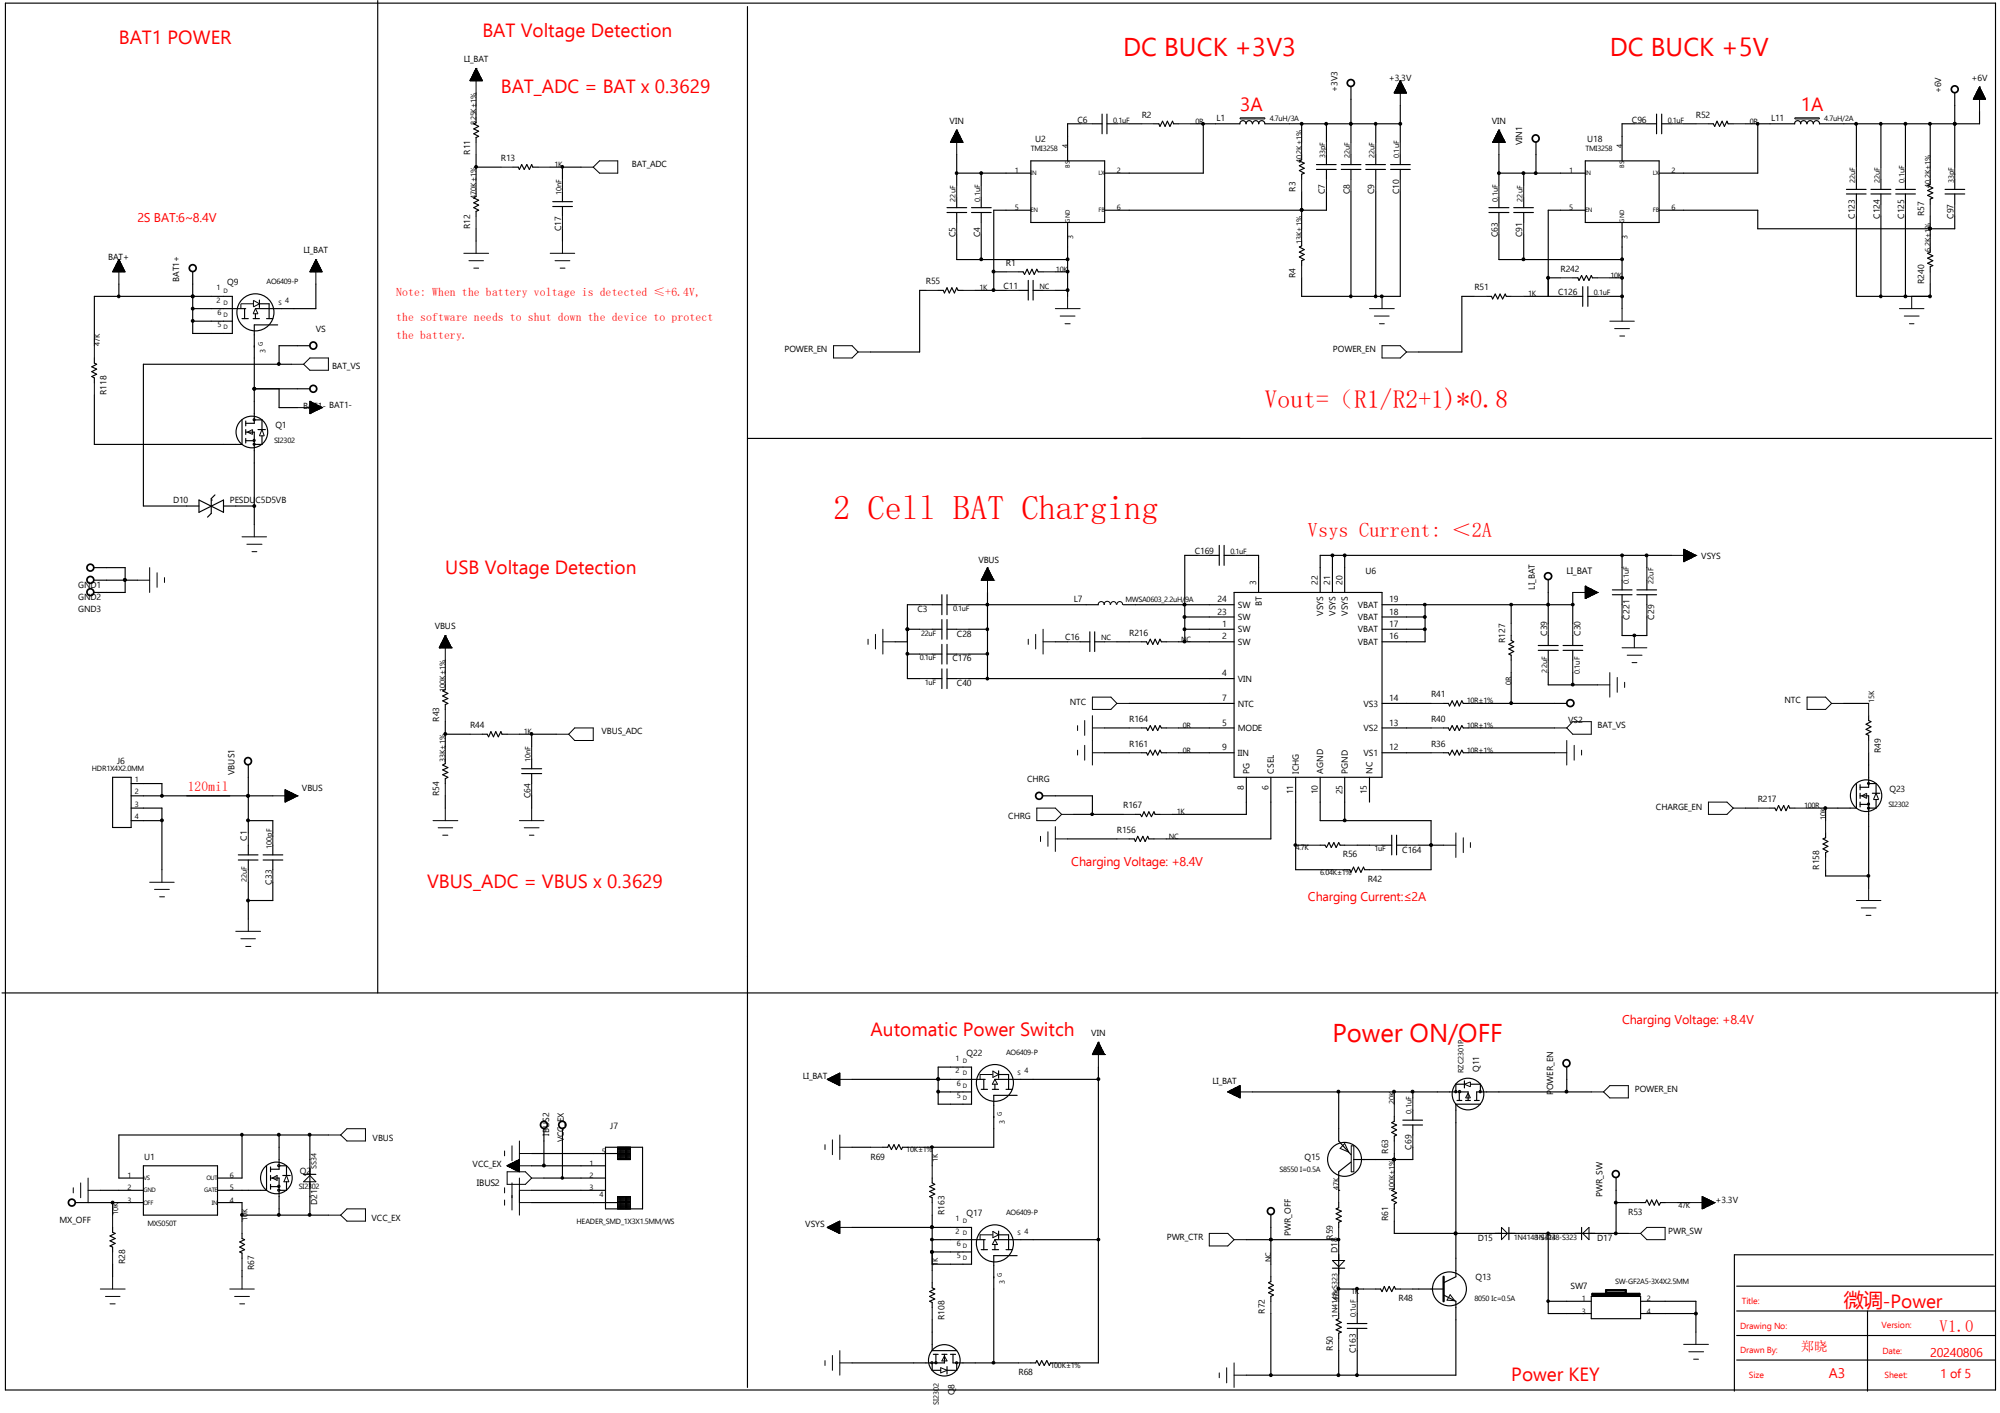
[picture p28: page 1]

Note: When the battery voltage is detected ≤+6.4V,

the software needs to shut down the device to protect
the battery.

Drawing No: | Version: V1.0
郑晓 Drawn By: | Date:

Size A3 | Sheet:

TR3- | TR3+ | TR4+ | TR4-
| | TR2- | TR2+

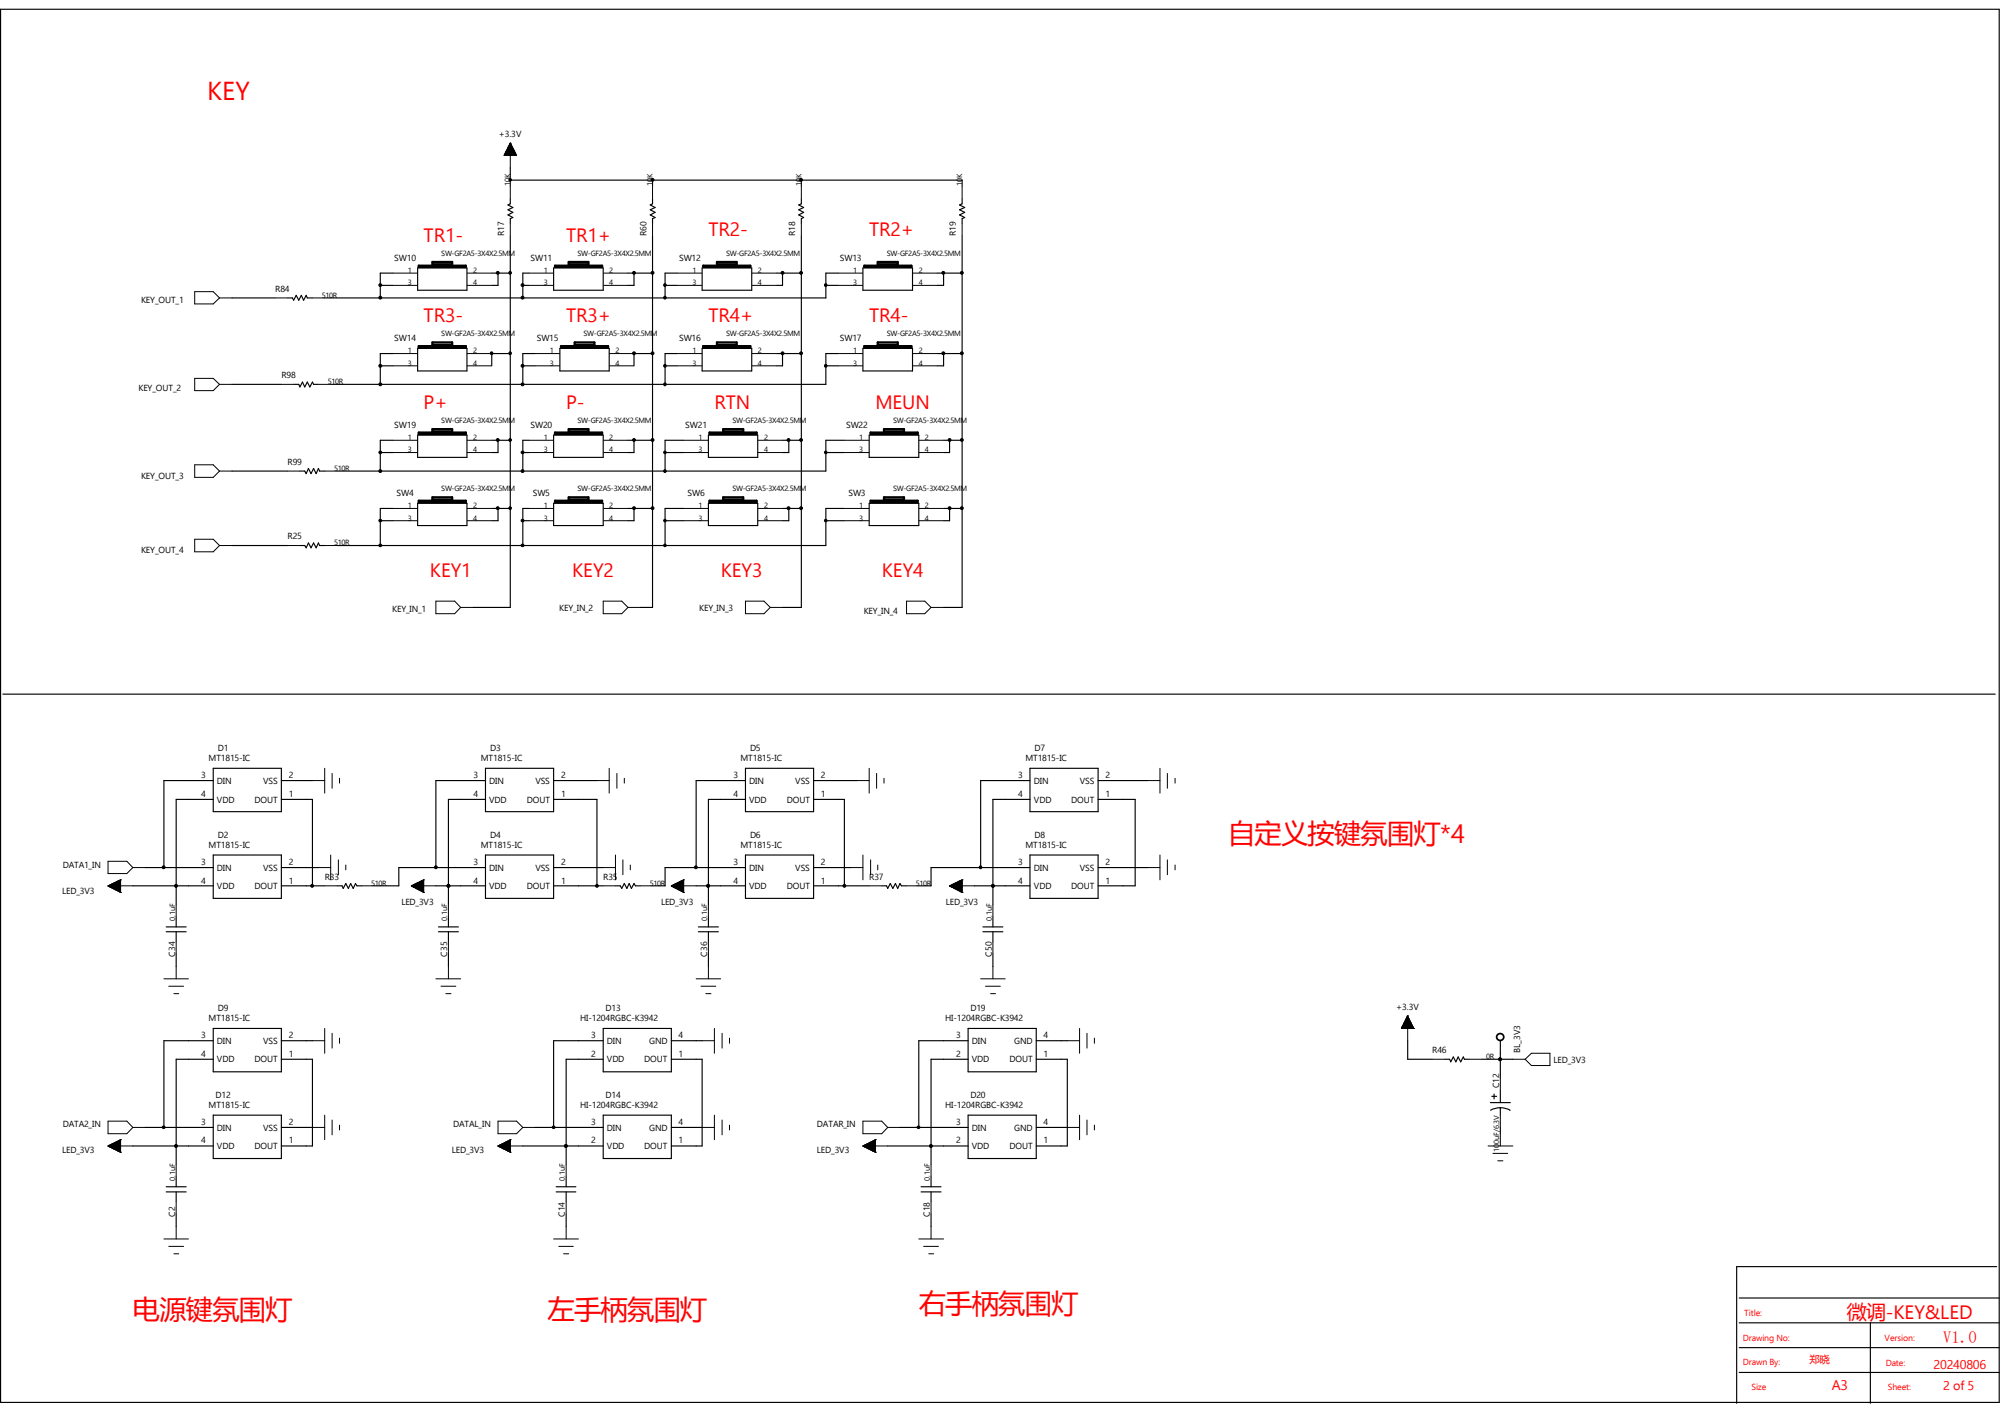
[picture p29: page 2]

# VR2 VR1

# Potentiometer Knob

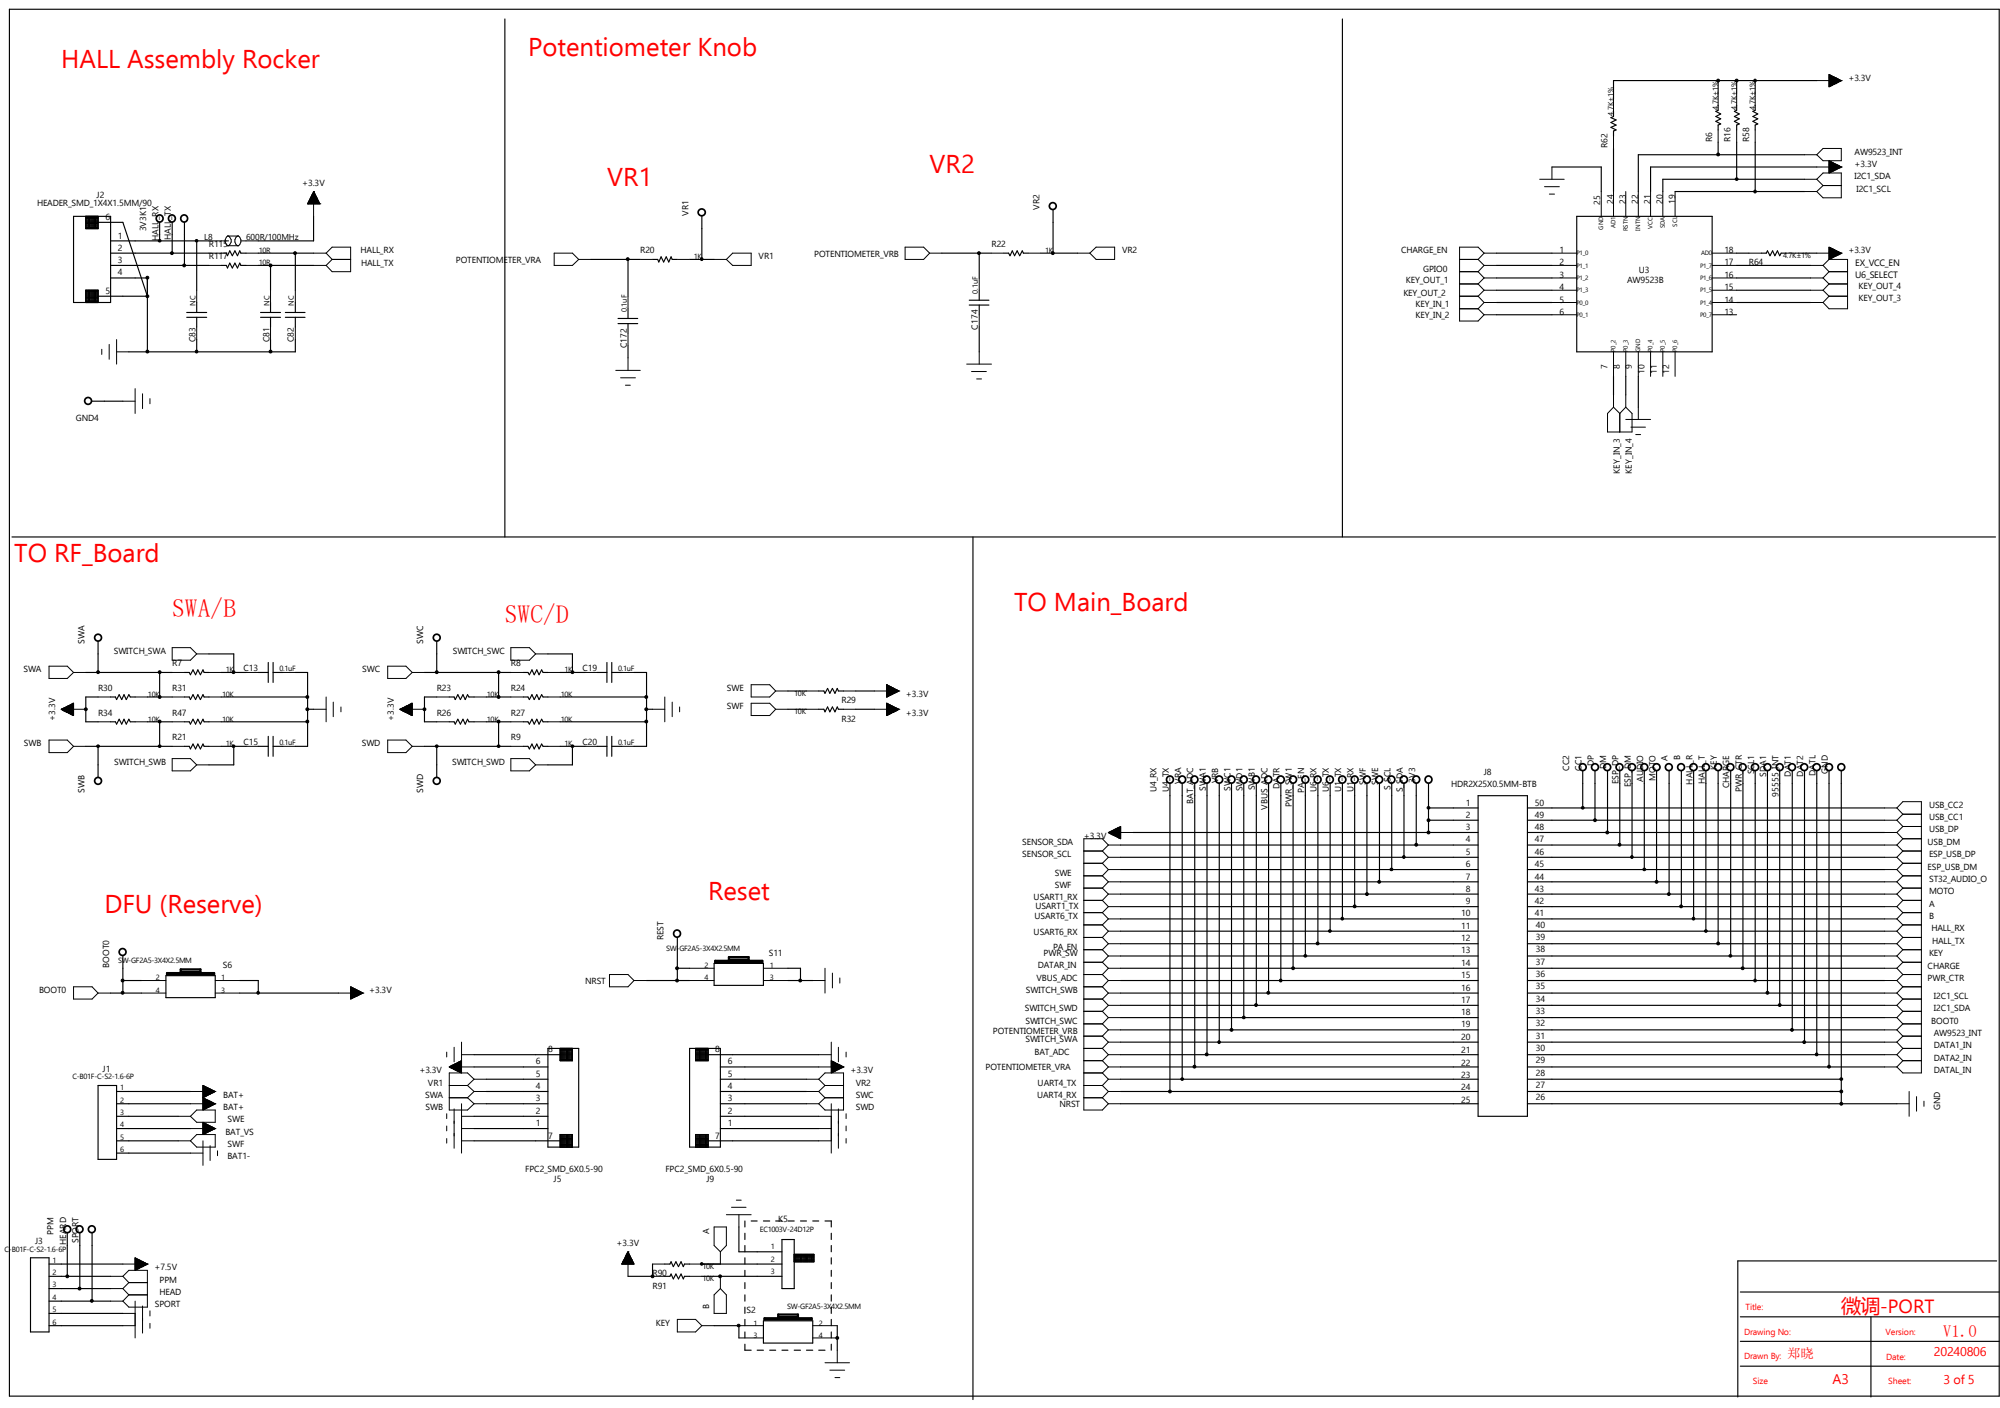
[picture p30: page 3]

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
# Audio Outputs

# Gyroscope

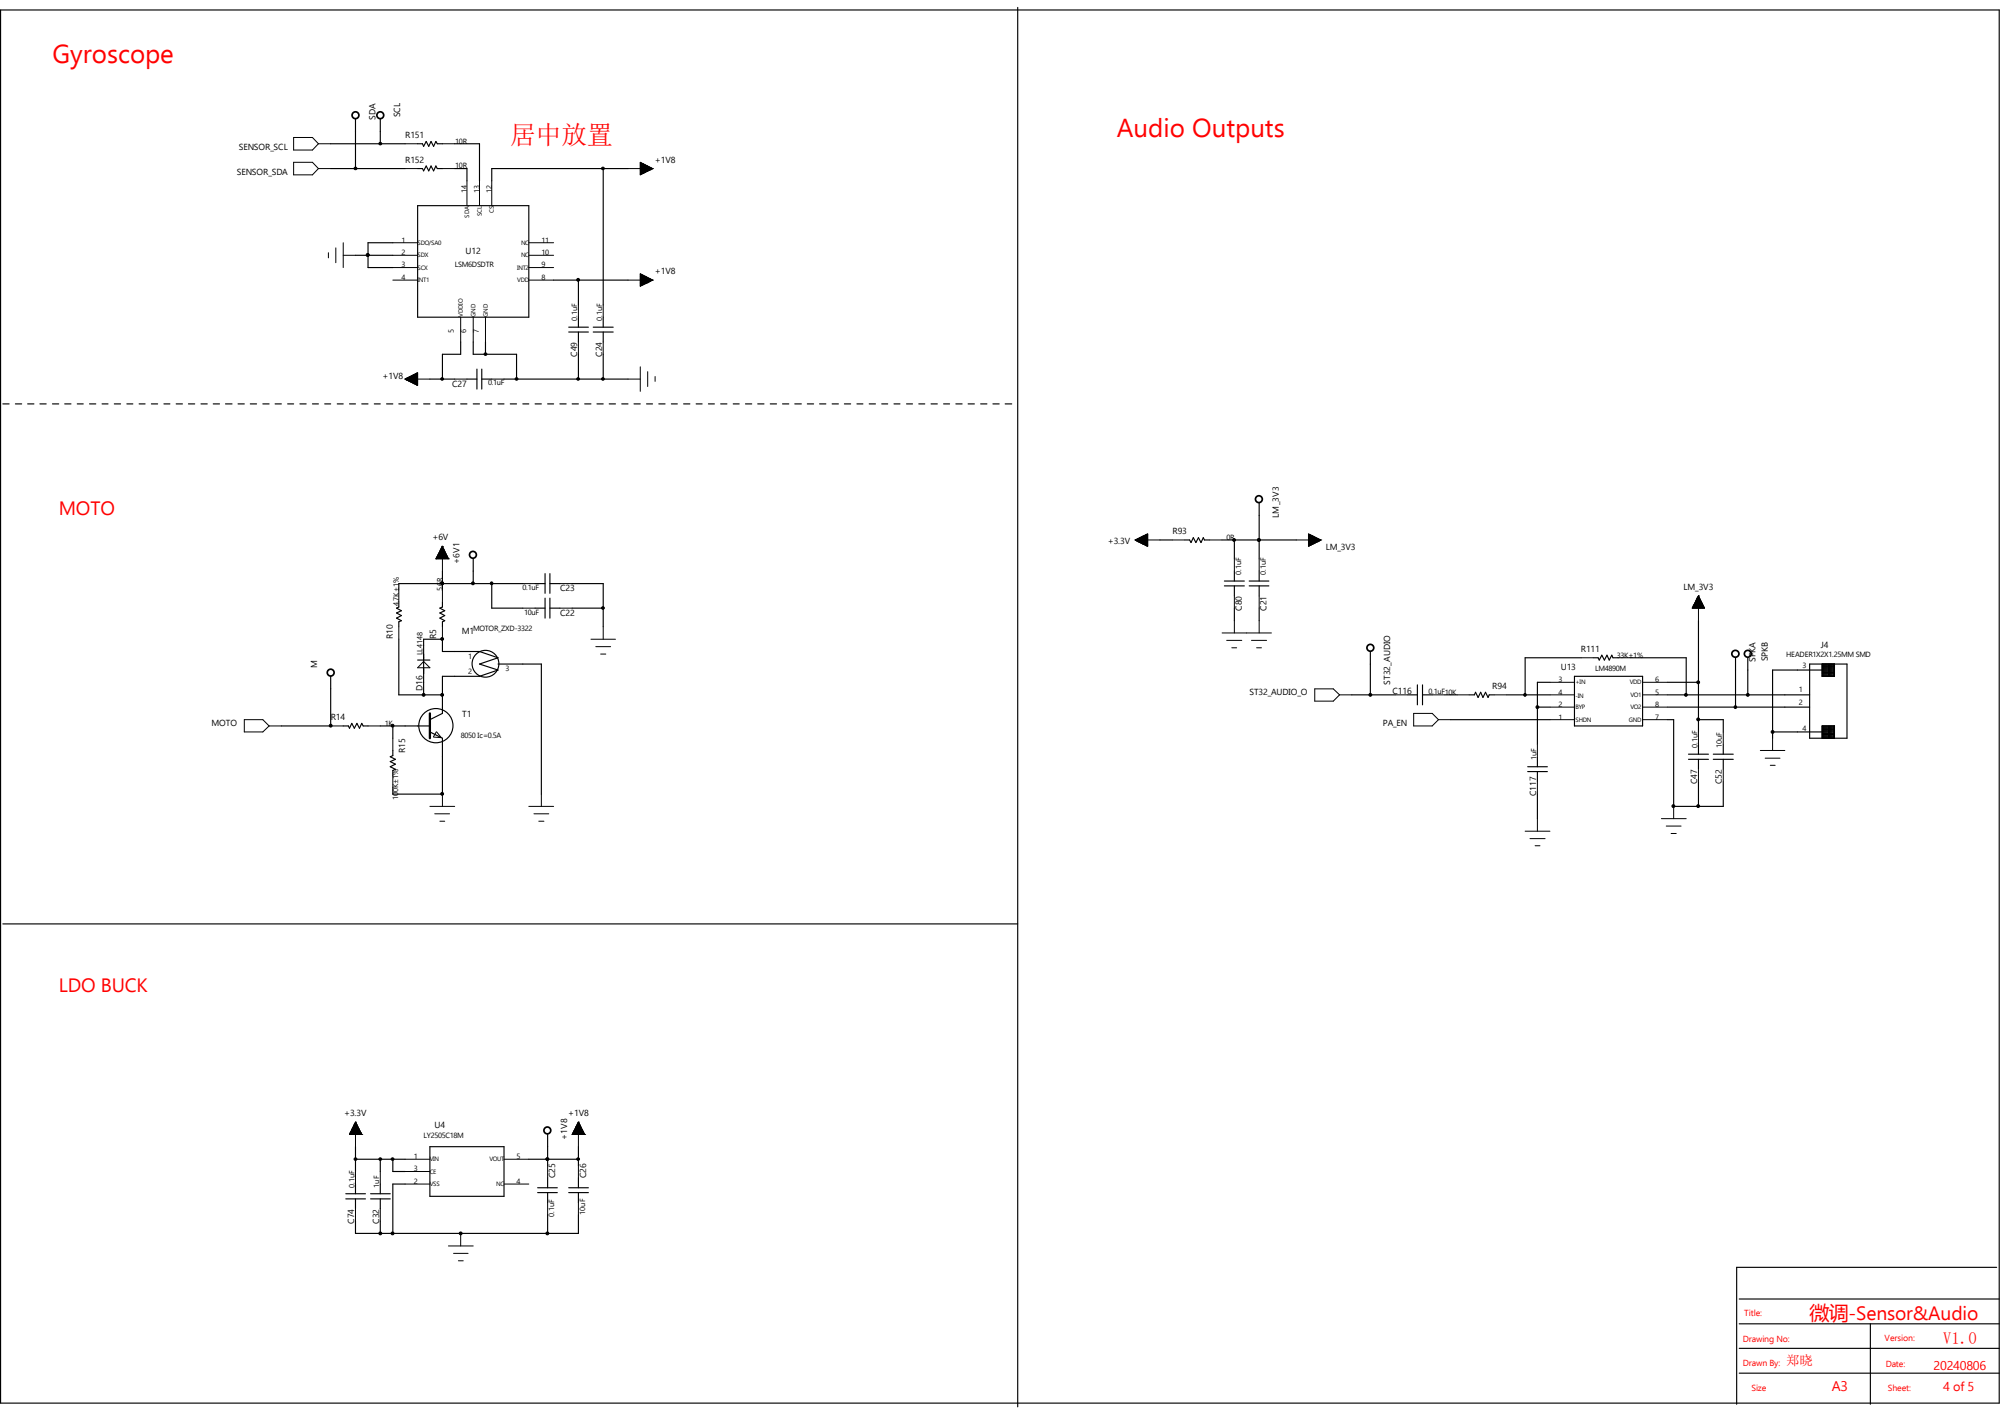
[picture p31: page 4]

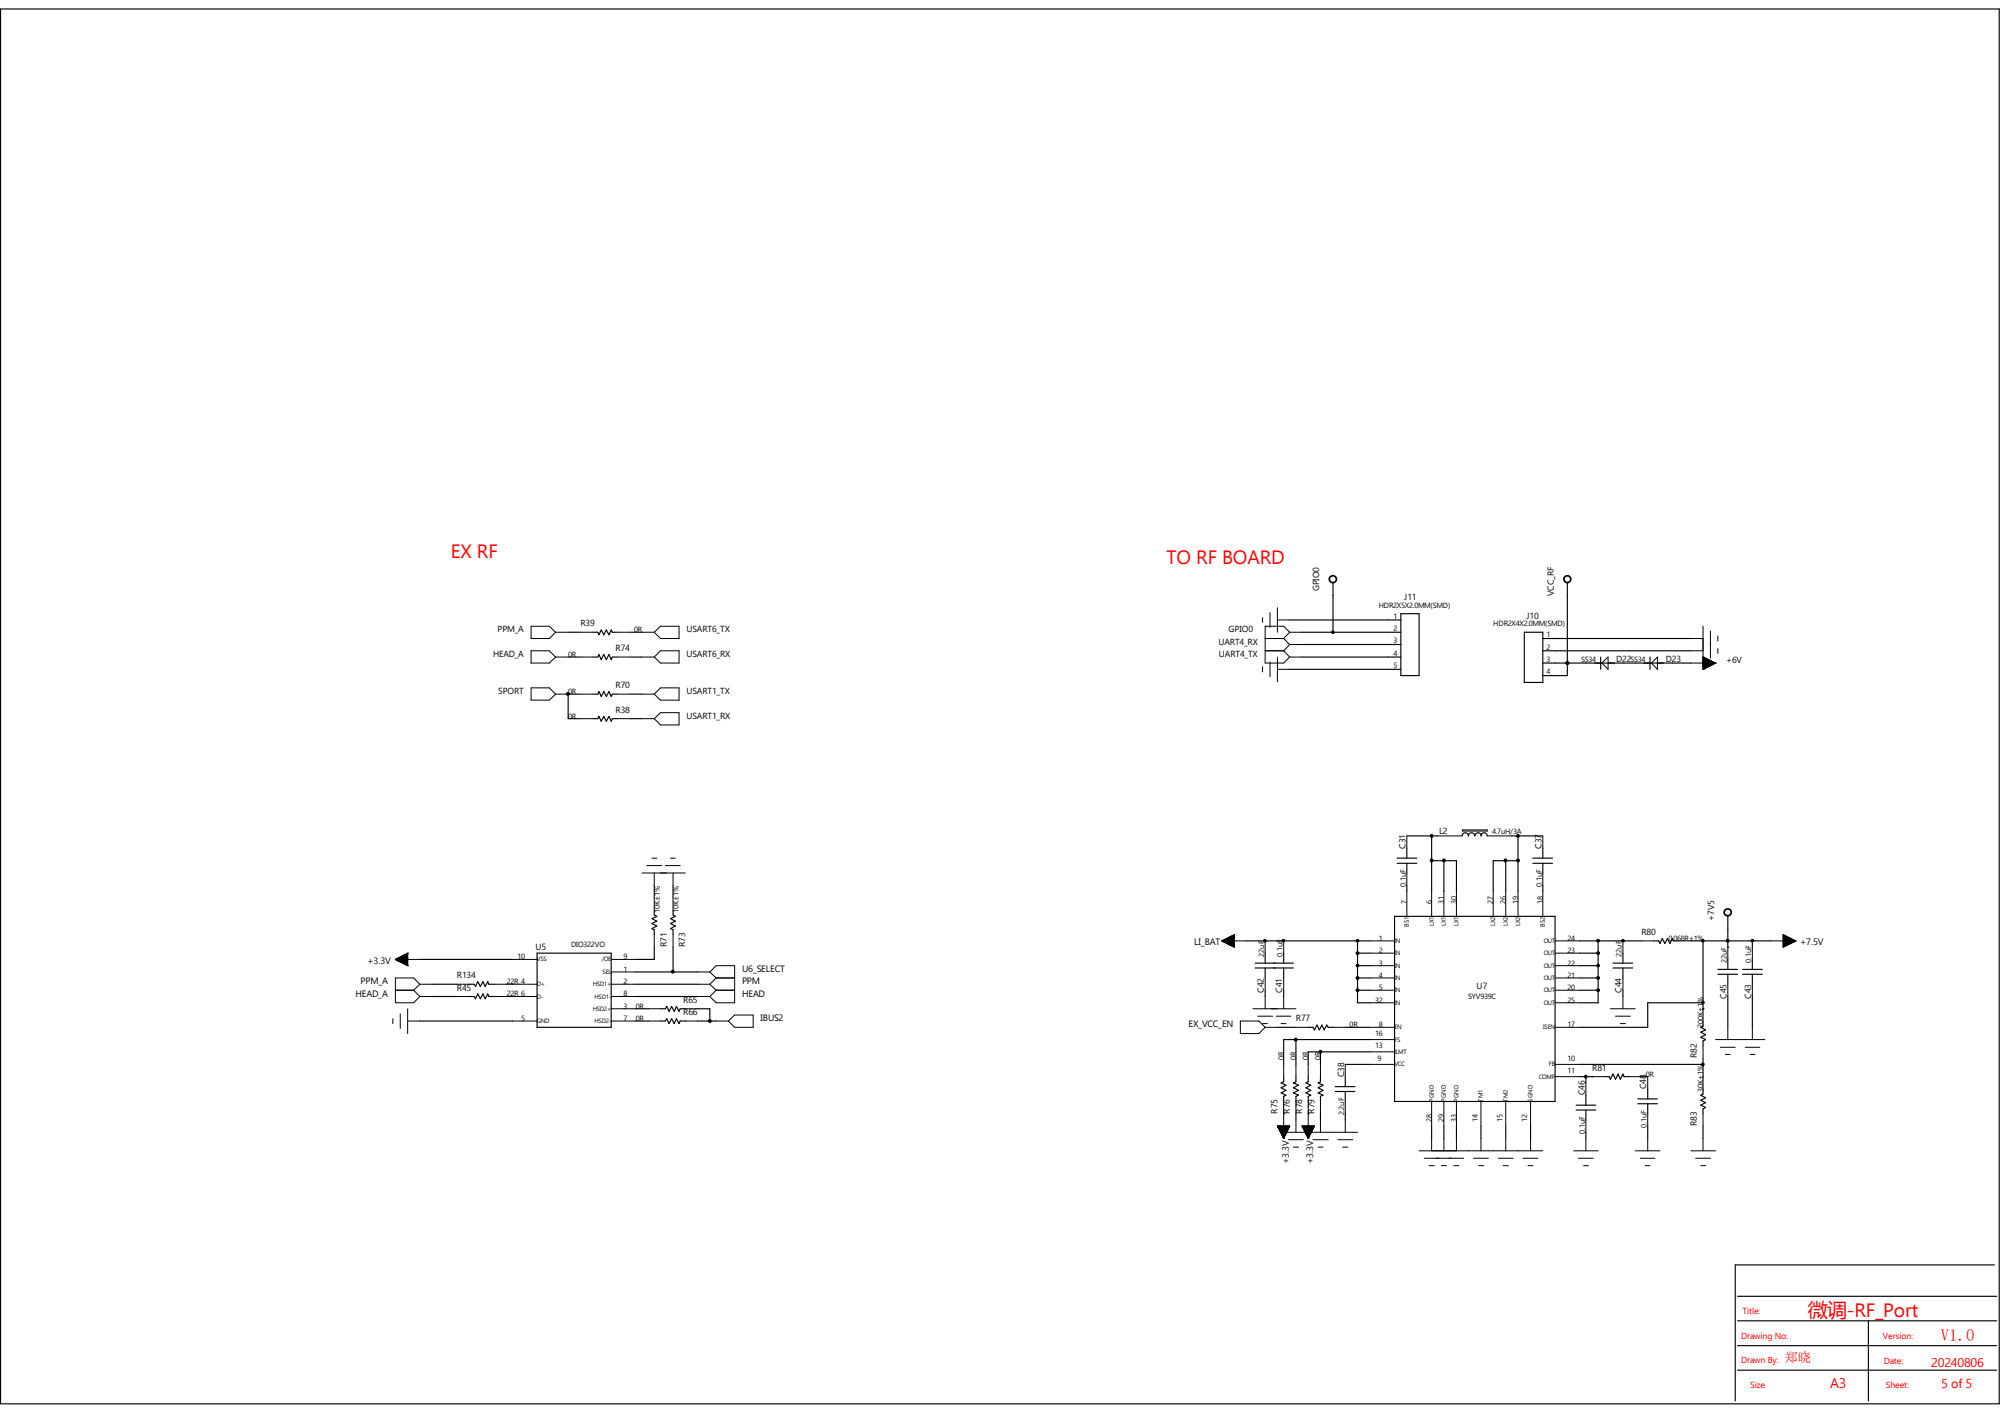
[picture p32: page 5]
