DQQ141/PA01/PA01/doc/原理图/others/PA01-RF-T0 20240806.pdf

KEY | EX_RF

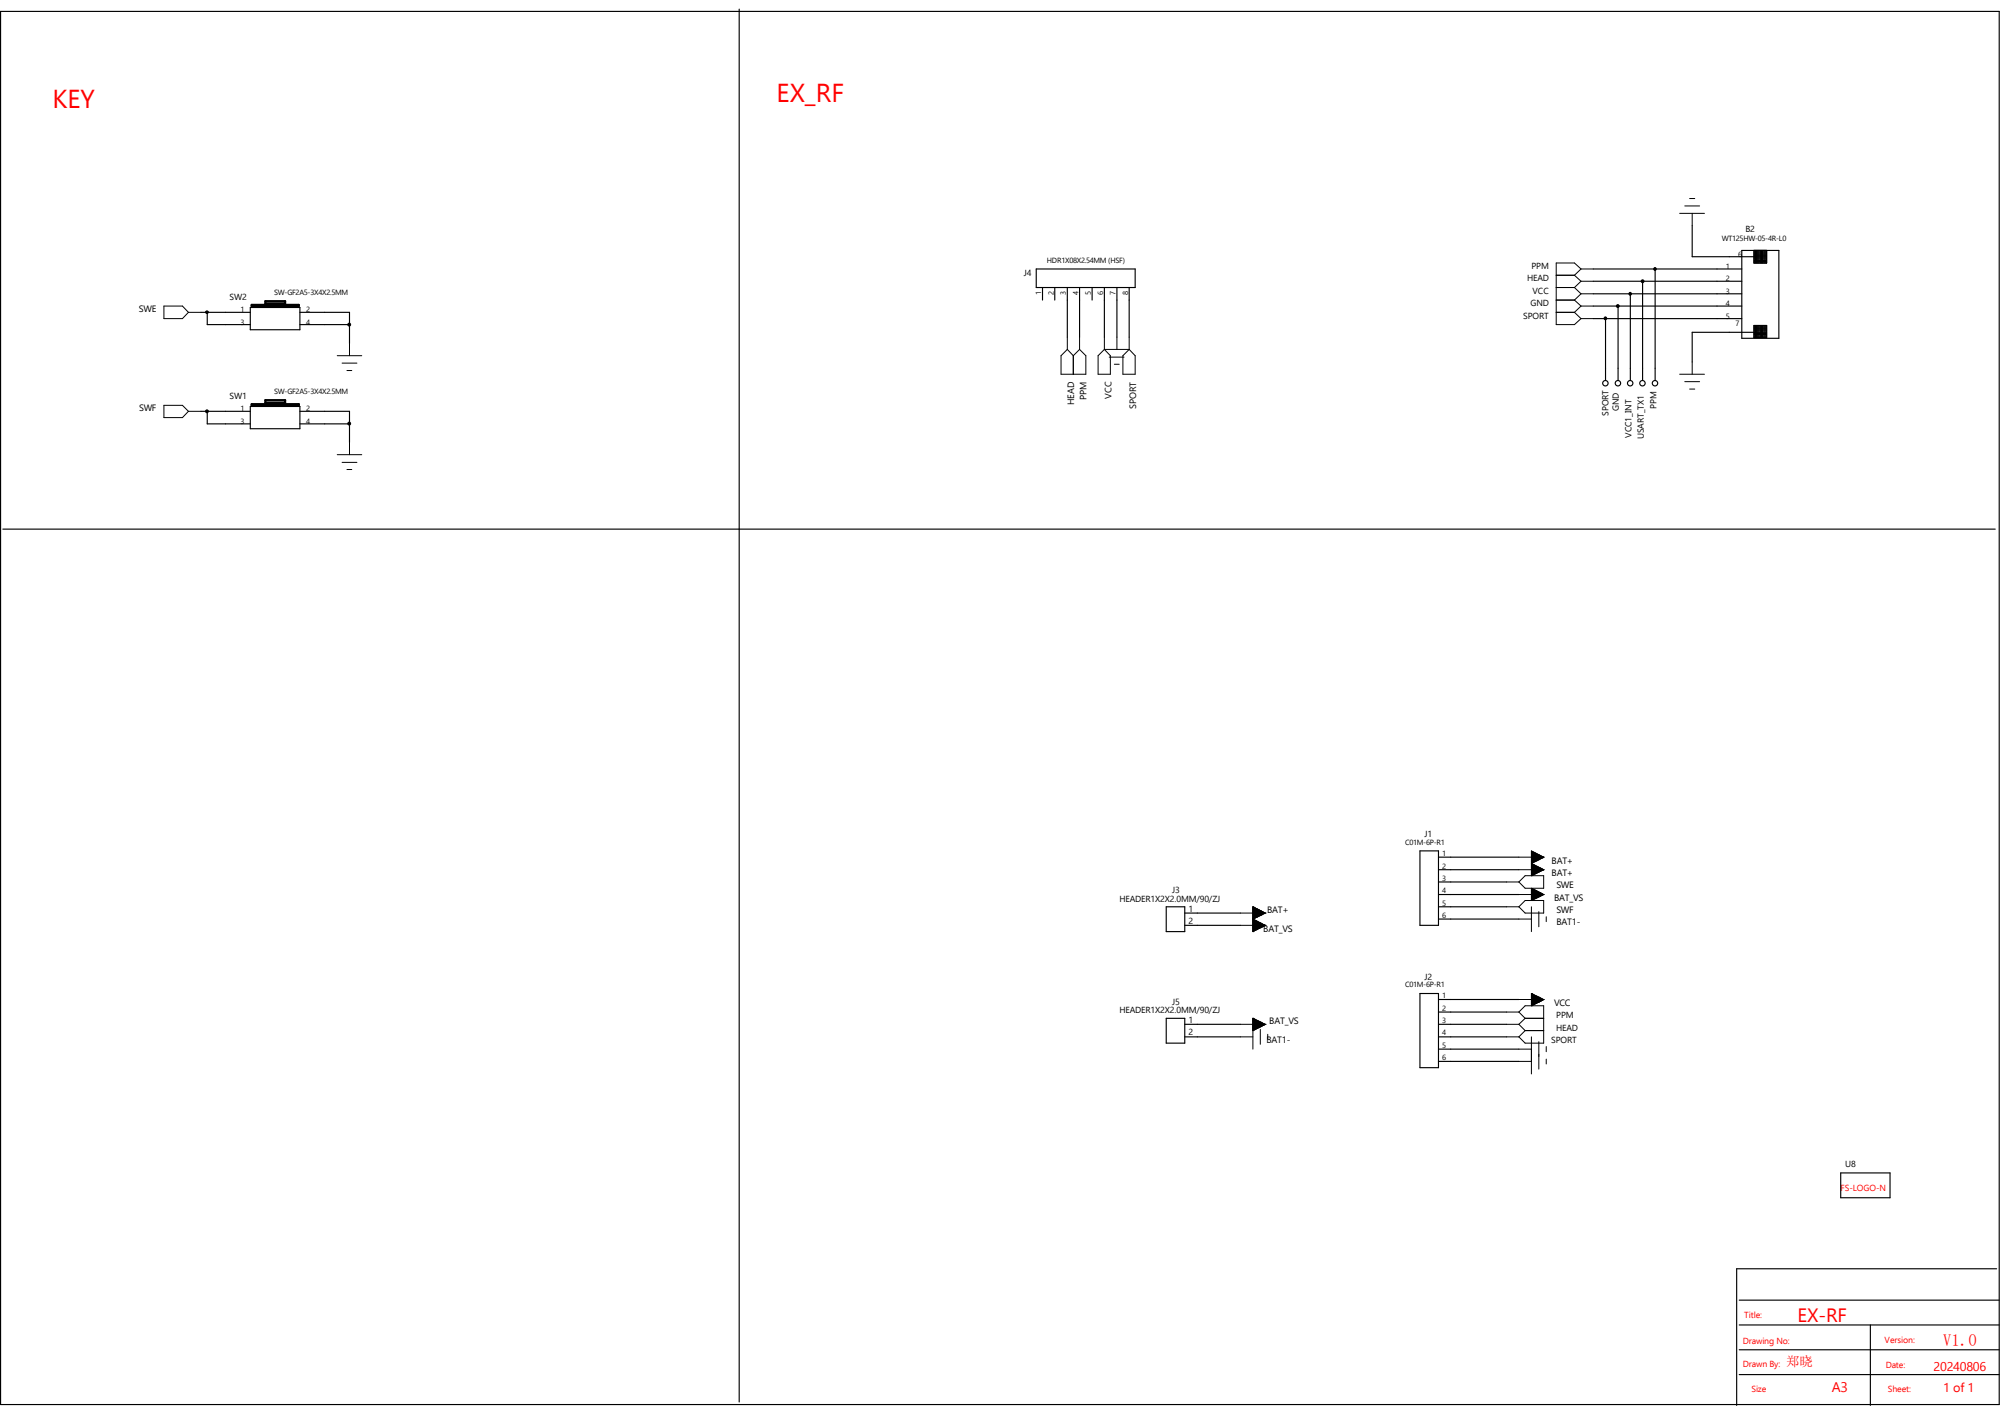
[picture p35: page 1]

Drawing No: | Version: V1.0
郑晓 Drawn By: | Date: 20240806

Size A3 | Sheet:
