DQQ141/PA01/PA01/msp/project.ioc

Mcu.UserName=STM32H750ZBTx
PA0.Signal=UART4_TX
PA1.Signal=UART4_RX
PA10.Signal=GPXTI10
PA11.Signal=USB_OTG_FS_DM
PA12.Signal=USB_OTG_FS_DP
PA2.Signal=GPIO_Input
PA3.Signal=ADCx_INP15
PA4.Signal=COMP_DAC11_group
PA5.Signal=ADCx_INP19
PA6.Signal=S_TIM3_CH1
PA7.Signal=S_TIM3_CH2
PA8.Signal=GPIO_Output
PA9.Signal=S_TIM1_CH2
PB0.Signal=ADCx_INP9
PB10.Signal=I2C2_SCL
PB11.Signal=I2C2_SDA
PB12.Signal=UART5_RX
PB13.Signal=UART5_TX
PB14.Signal=USART1_TX
PB15.Signal=USART1_RX
PB2.Signal=QUADSPI_CLK
PB5.Signal=SPI1_MOSI
PB6.Signal=QUADSPI_BK1_NCS
PB7.Signal=GPXTI7
PB8.Signal=I2C1_SCL
PB9.Signal=I2C1_SDA
PC0.Signal=FMC_SDNWE
PC1.Signal=ADCx_INP11
PC10.Signal=SDMMC1_D2
PC11.Signal=SDMMC1_D3
PC12.Signal=SDMMC1_CK
PC2_C.Signal=FMC_SDNE0
PC3_C.Signal=FMC_SDCKE0
PC4.Signal=ADCx_INP4
PC5.Signal=ADCx_INP8
PC6.Signal=USART6_TX
PC7.Signal=USART6_RX
PC8.Signal=SDMMC1_D0
PC9.Signal=SDMMC1_D1
PD0.Signal=FMC_D2_DA2
PD1.Signal=FMC_D3_DA3
PD10.Signal=FMC_D15_DA15
PD11.Signal=QUADSPI_BK1_IO0
PD12.Signal=QUADSPI_BK1_IO1
PD13.Signal=QUADSPI_BK1_IO3
PD14.Signal=FMC_D0_DA0
PD15.Signal=FMC_D1_DA1
PD2.Signal=SDMMC1_CMD
PD3.Signal=GPIO_Input
PD4.Signal=GPXTI4
PD5.Signal=USART2_TX
PD6.Signal=USART2_RX
PD7.Signal=GPIO_Output
PD8.Signal=FMC_D13_DA13
PD9.Signal=FMC_D14_DA14
PE0.Signal=FMC_NBL0
PE1.Signal=FMC_NBL1
PE10.Signal=FMC_D7_DA7
PE11.Signal=FMC_D8_DA8
PE12.Signal=FMC_D9_DA9
PE13.Signal=FMC_D10_DA10
PE14.Signal=FMC_D11_DA11
PE15.Signal=FMC_D12_DA12
PE2.Signal=QUADSPI_BK1_IO2
PE3.Signal=GPIO_Output
PE4.Signal=GPIO_Output
PE5.Signal=GPIO_Input
PE6.Signal=GPIO_Input
PE7.Signal=FMC_D4_DA4
PE8.Signal=FMC_D5_DA5
PE9.Signal=FMC_D6_DA6
PF0.Signal=FMC_A0
PF1.Signal=FMC_A1
PF11.Signal=FMC_SDNRAS
PF12.Signal=FMC_A6
PF13.Signal=FMC_A7
PF14.Signal=FMC_A8
PF15.Signal=FMC_A9
PF2.Signal=FMC_A2
PF3.Signal=FMC_A3
PF4.Signal=FMC_A4
PF5.Signal=FMC_A5
PF6.Signal=S_TIM16_CH1
PF7.Signal=ADC3_INP3
PF8.Signal=GPIO_Input
PG0.Signal=FMC_A10
PG1.Signal=FMC_A11
PG10.Signal=GPIO_Output
PG11.Signal=SPI1_SCK
PG12.Signal=GPIO_Output
PG13.Signal=GPIO_Input
PG15.Signal=FMC_SDNCAS
PG2.Signal=GPIO_Input
PG3.Signal=GPIO_Input
PG4.Signal=FMC_A14_BA0
PG5.Signal=FMC_A15_BA1
PG6.Signal=GPIO_Input
PG8.Signal=FMC_SDCLK
