DQQ141/PA01/PA01/msp/msp_hal/i2c/i2c_msp.h

/**
 * @file uart_msp.h
 * @author WittXie
 * @brief 芯片层I2C支持包
 * @version 0.1
 * @date 2024-05-30
 * @note timing = (PRESC << 28) | (SCLDEL << 20) | (SDADEL << 16) | (SCLH << 8) | SCLL
 *
 * @copyright Copyright (c) 2024
 *
 */
#pragma once

#include "./../msp_env.h"

/**
 * @brief 获取I2C名字字符串
 *
 * @param Instance I2C
 *
 * @return const char* I2C名字字符串
 */
const char *i2c_name_str_get(I2C_TypeDef *Instance);

/**
 * @brief 获取I2C错误码字符串
 *
 * @param ErrorCode 错误码
 * @return const char* I2C名字字符串
 */
const char *i2c_error_str_get(uint32_t ErrorCode);
