DQQ141/PA01/PA01/app/test/test_app.h

/**
 * @file test_app.h
 * @author WittXie
 * @brief 测试应用
 * @version 0.1
 * @date 2023-03-30
 *
 * @copyright Copyright (c) 2023
 *
 */
#pragma once

// 依赖
#include "./../app_env.h"
#include "./../factory/factory_app.h"

/**
 * @brief 初始化
 *
 */
void test_app_init(void);
